architecture-building-systems/FCL-Exhibition-2023-Arduino/README.md

# FCL-Exhibition-2023
Arduino Installation 

Files and codes for the
- Arduino Sundomes

|  | 
|:--:| 
| *ETH main bulding Zurich 12 October 2023* |
