architecture-building-systems/FCL-Exhibition-2023-Arduino/09_Documentation/Images/2 axis prototype disect.pdf

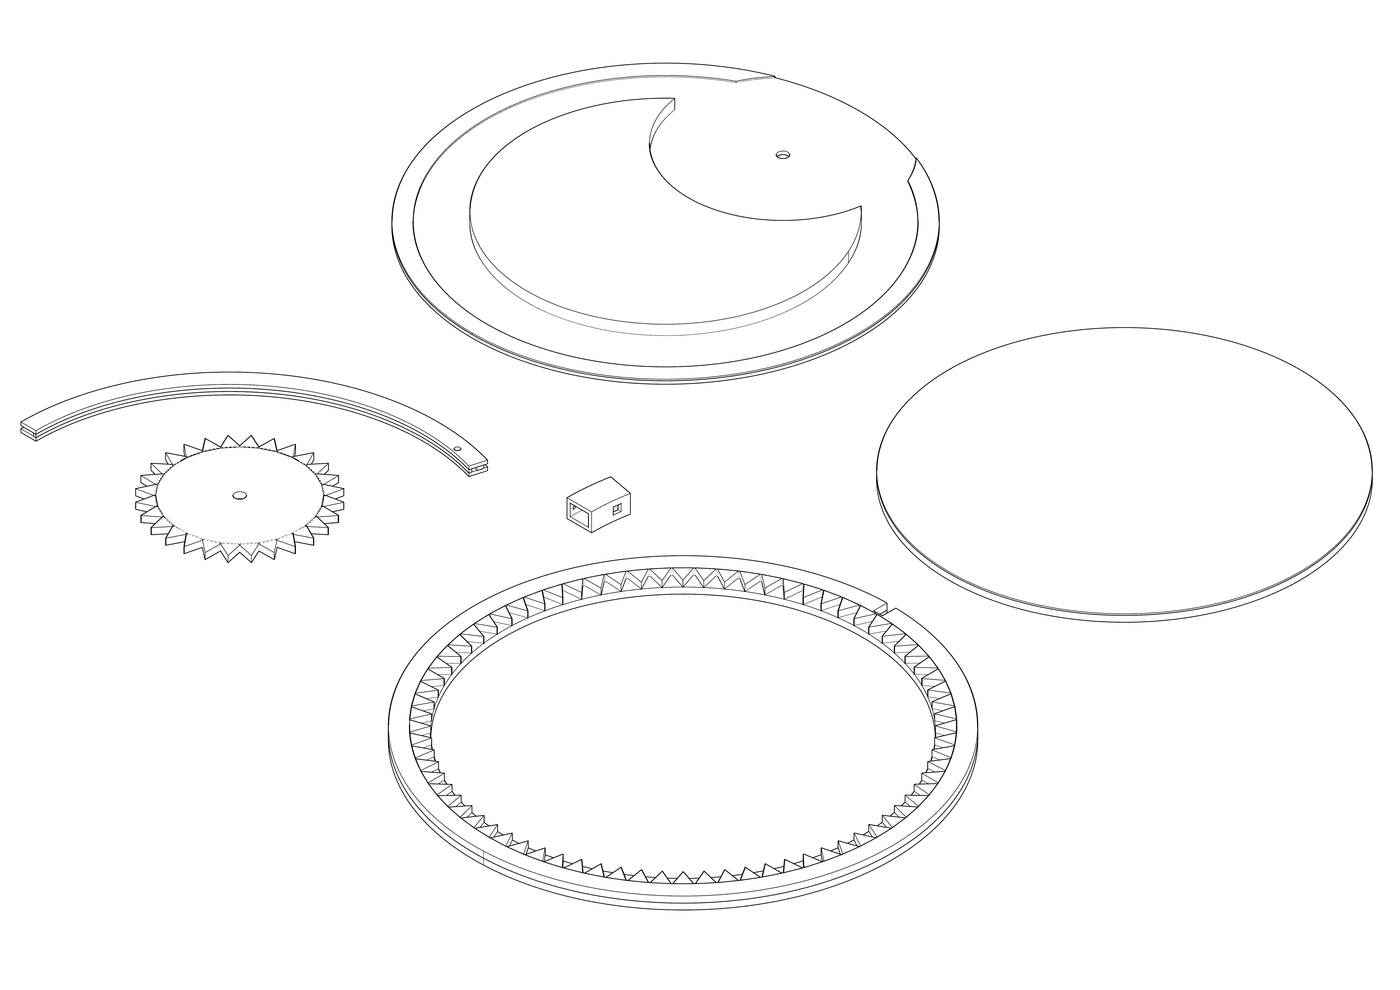
[picture p62: page 1]
