architecture-building-systems/FCL-Exhibition-2023-Arduino/09_Documentation/Images/2 axis prototype total.pdf

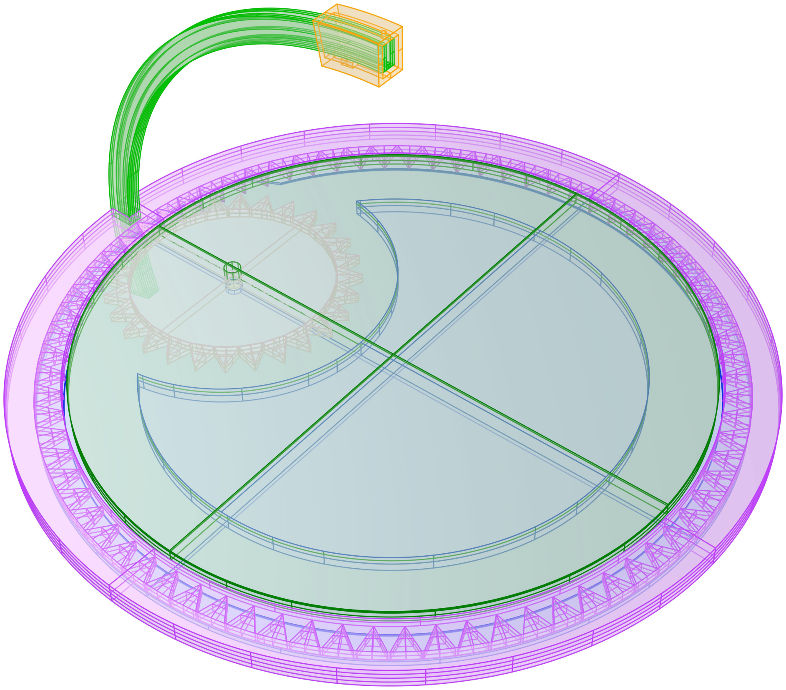
[picture p63: page 1]
