architecture-building-systems/FCL-Exhibition-2023-Arduino/09_Documentation/Images/modelsg.pdf

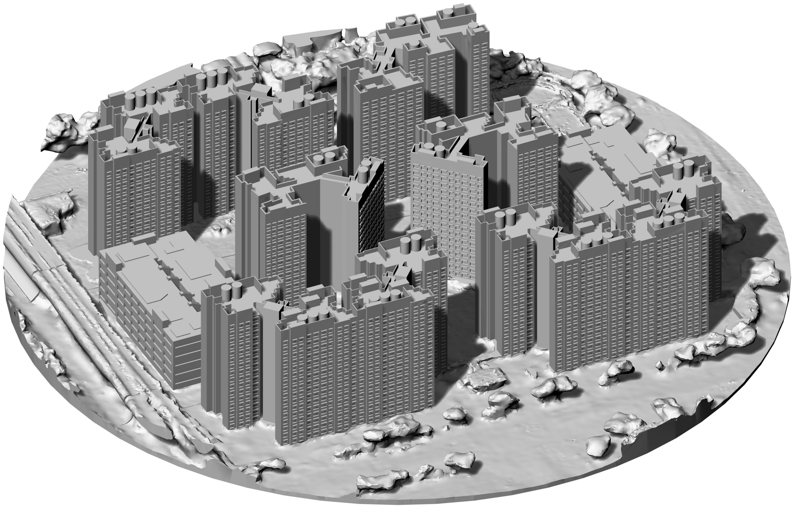
[picture p64: page 1]
