architecture-building-systems/FCL-Exhibition-2023-Arduino/09_Documentation/Images/modelzh.pdf

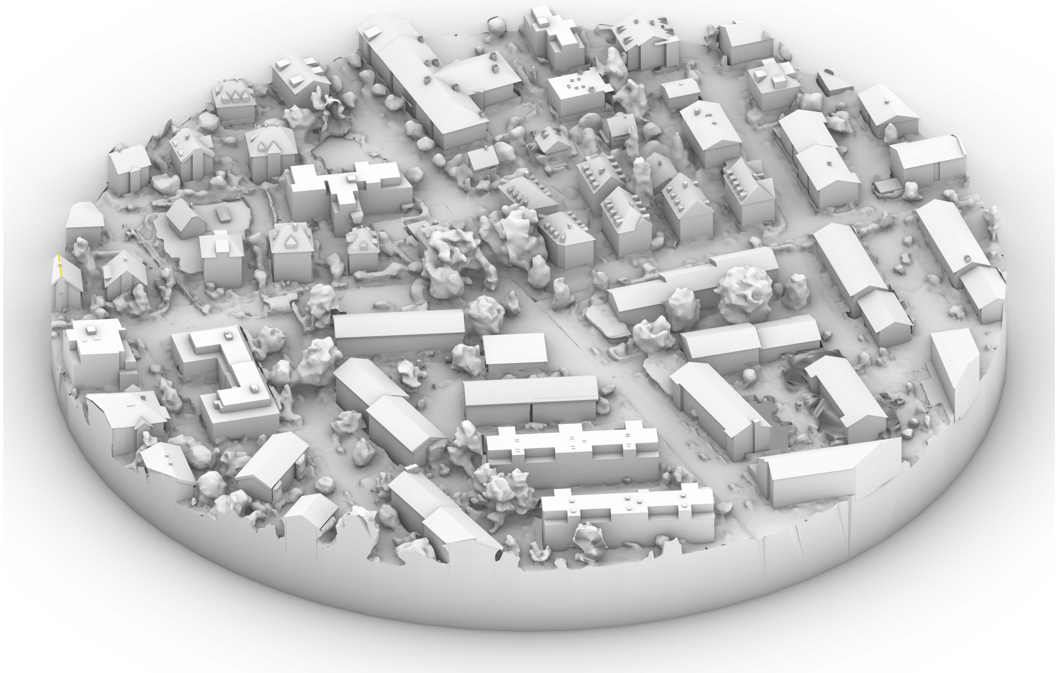
[picture p65: page 1]
