architecture-building-systems/FCL-Exhibition-2023-Arduino/09_Documentation/Images/ring prototype_v1 - disect.pdf

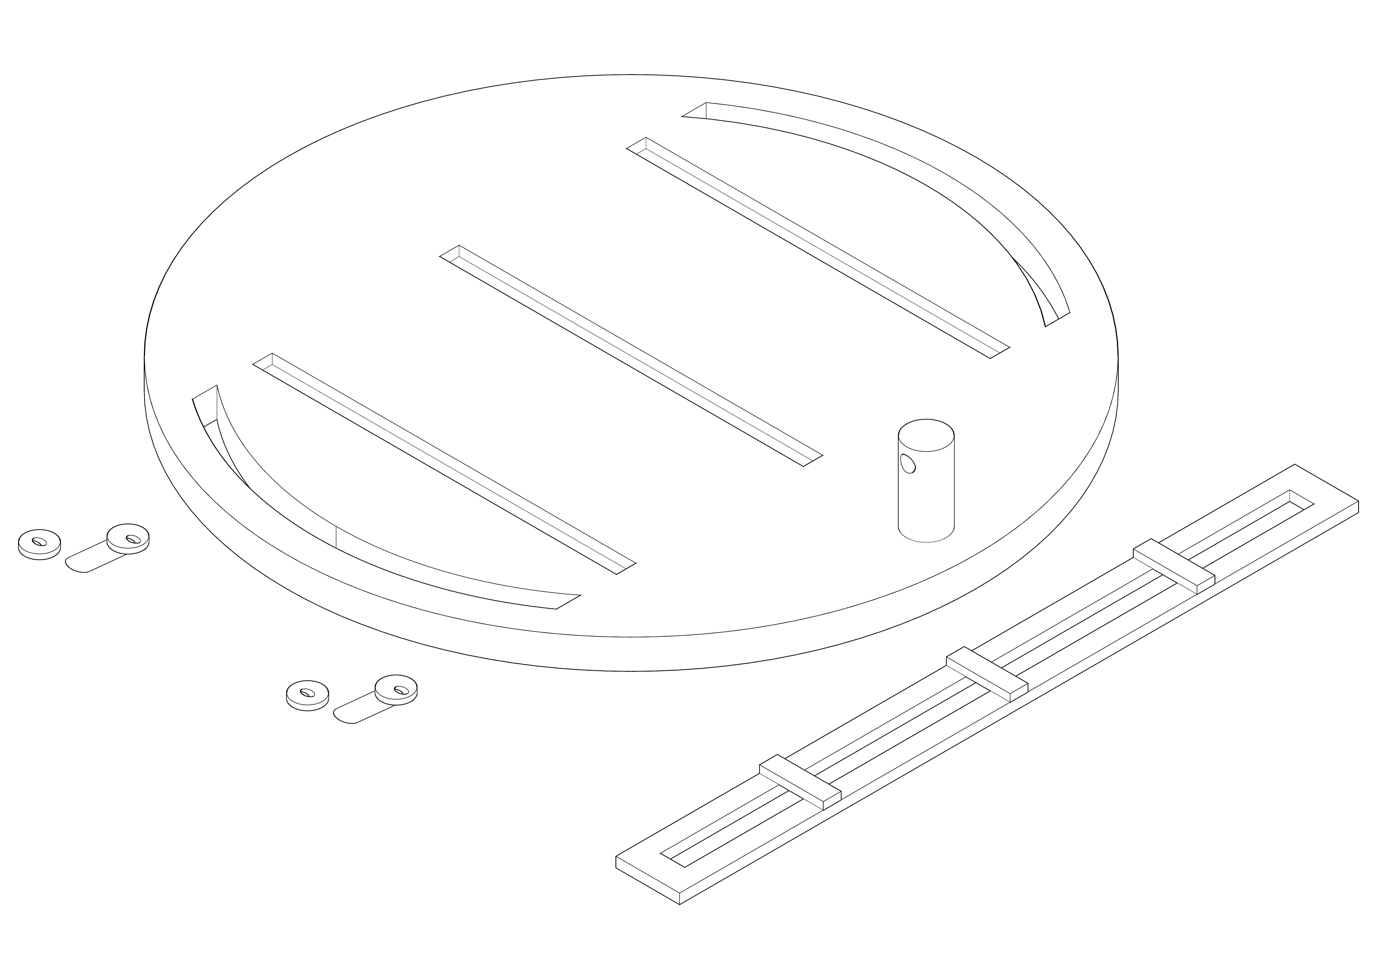
[picture p66: page 1]
