architecture-building-systems/FCL-Exhibition-2023-Arduino/09_Documentation/Images/ring prototype_v1 - total.pdf

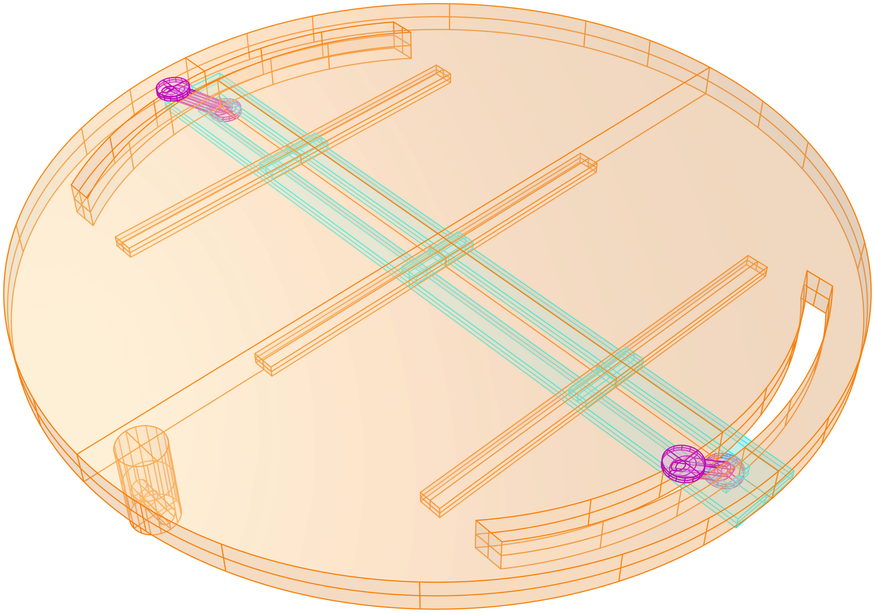
[picture p67: page 1]
