architecture-building-systems/FCL-Exhibition-2023-Arduino/09_Documentation/Images/ring prototype_v2 disect.pdf

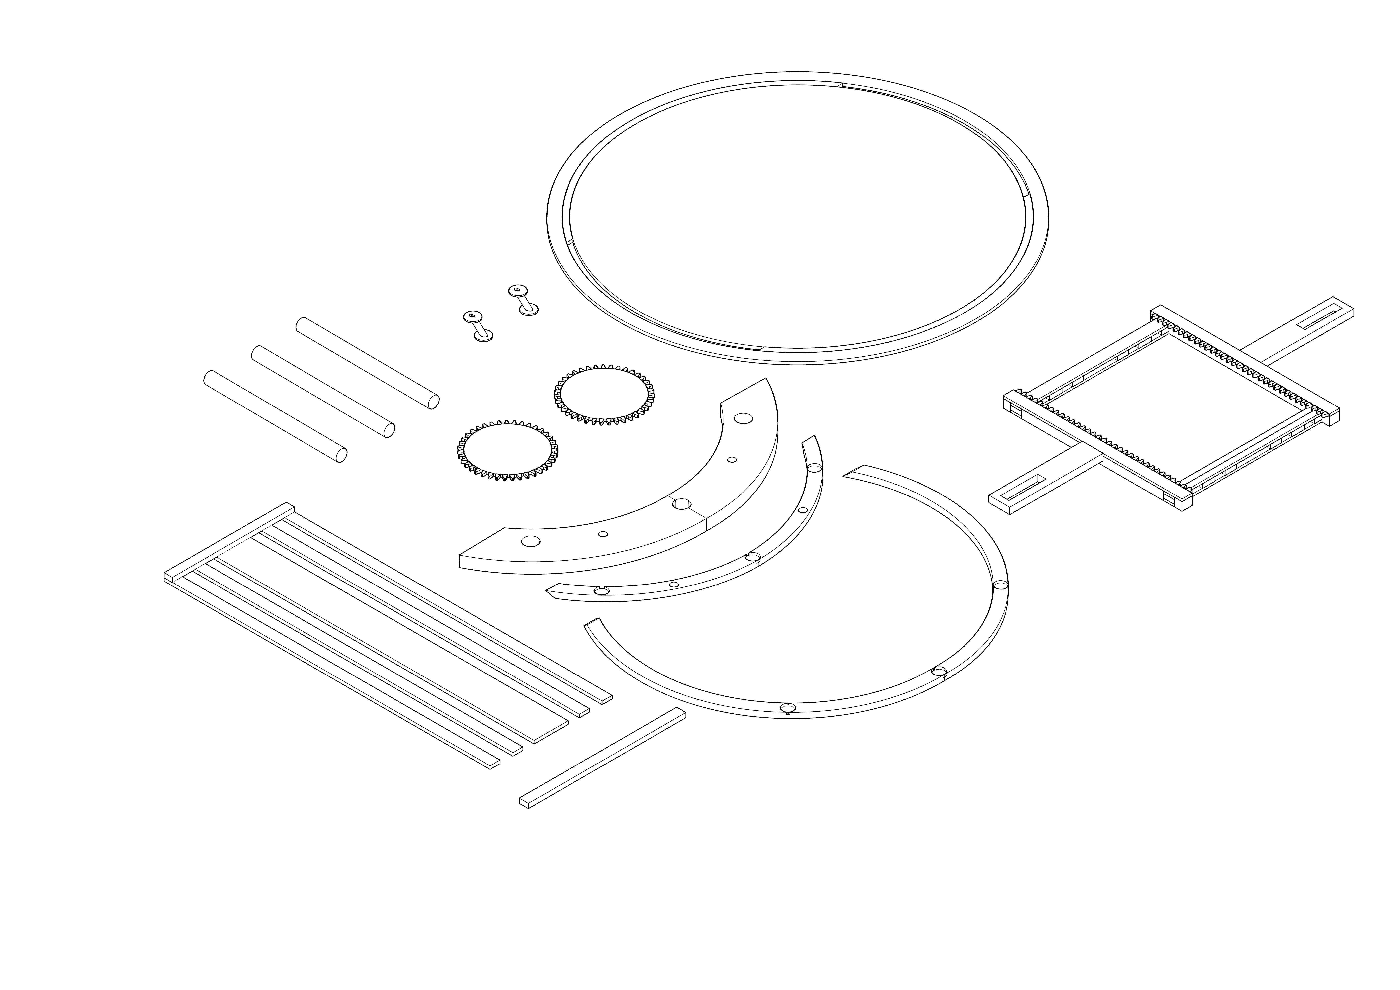
[picture p68: page 1]
