architecture-building-systems/FCL-Exhibition-2023-Arduino/09_Documentation/Images/ring prototype_v2 total.pdf

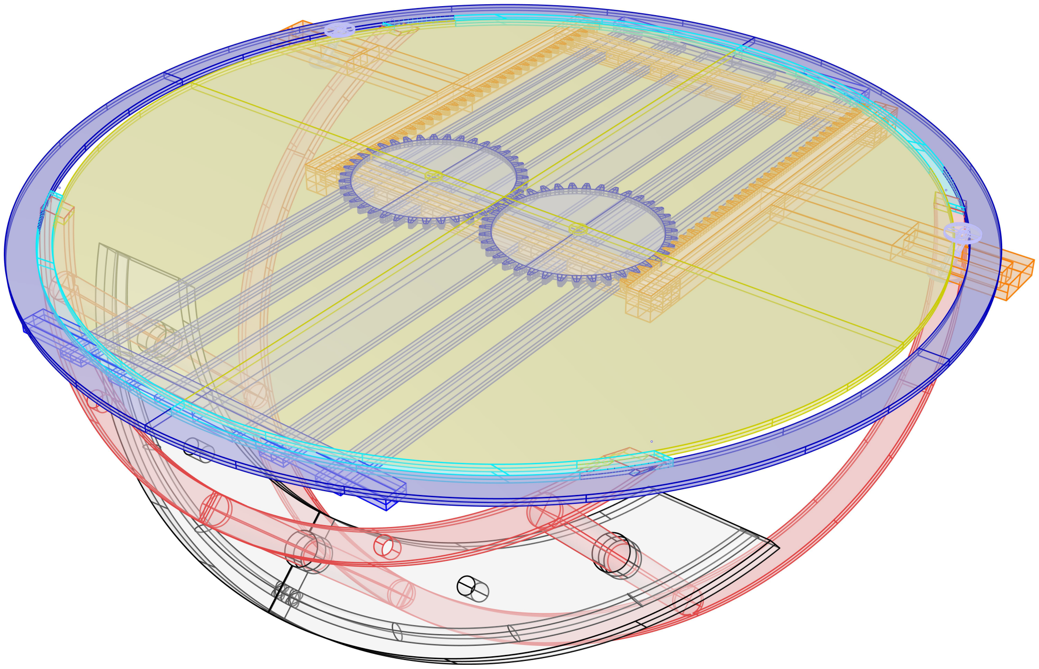
[picture p69: page 1]
