architecture-building-systems/FCL-Exhibition-2023-Arduino/09_Documentation/Images/7.jpg

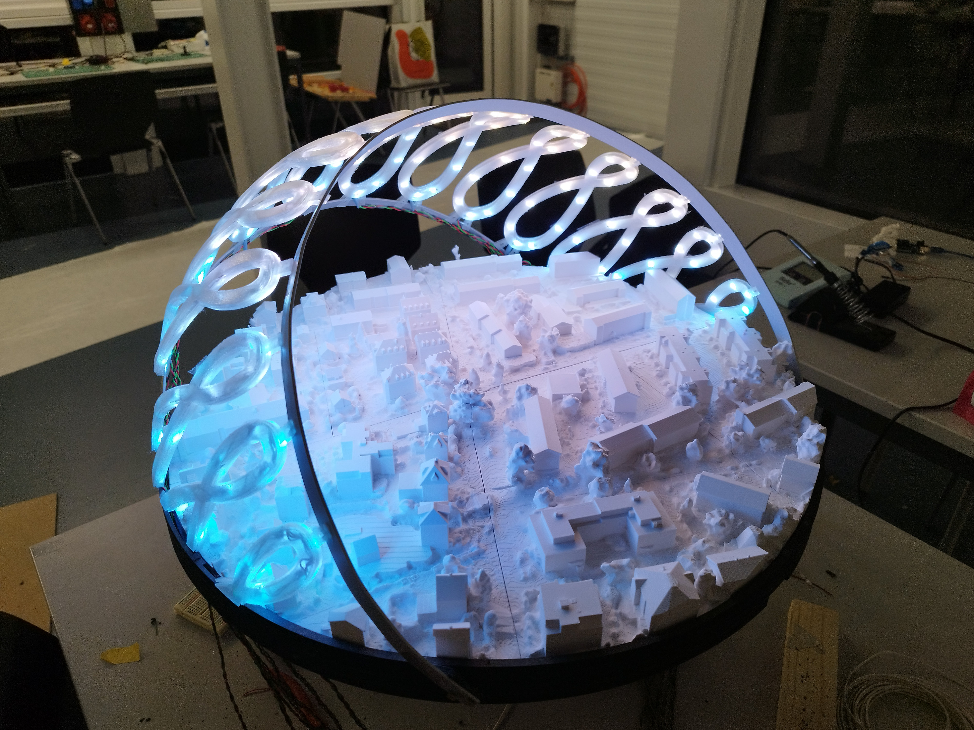
09_Documentation/Images/7.jpg
