architecture-building-systems/FCL-Exhibition-2023-Arduino/09_Documentation/Images/11.jpg

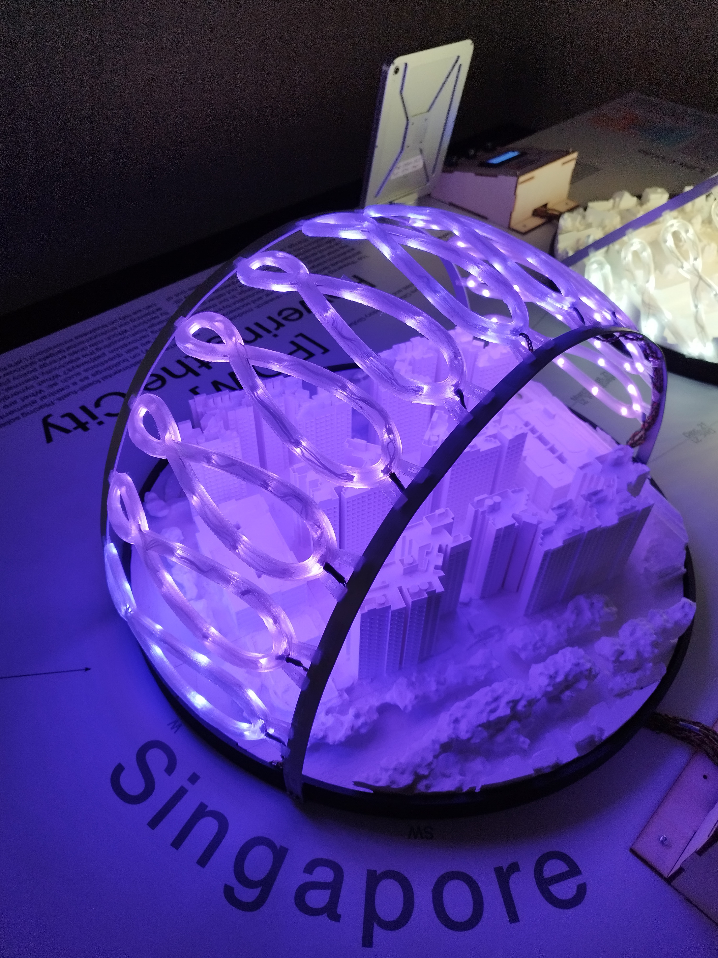
09_Documentation/Images/11.jpg
