architecture-building-systems/FCL-Exhibition-2023-Arduino/09_Documentation/Images/closedv2_1.jpg

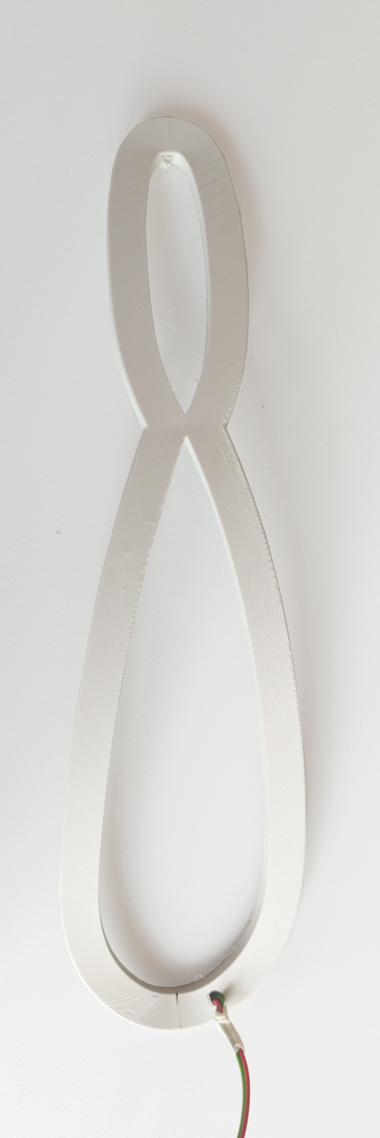
09_Documentation/Images/closedv2_1.jpg
