architecture-building-systems/FCL-Exhibition-2023-Arduino/09_Documentation/Images/scheme led_1.jpg

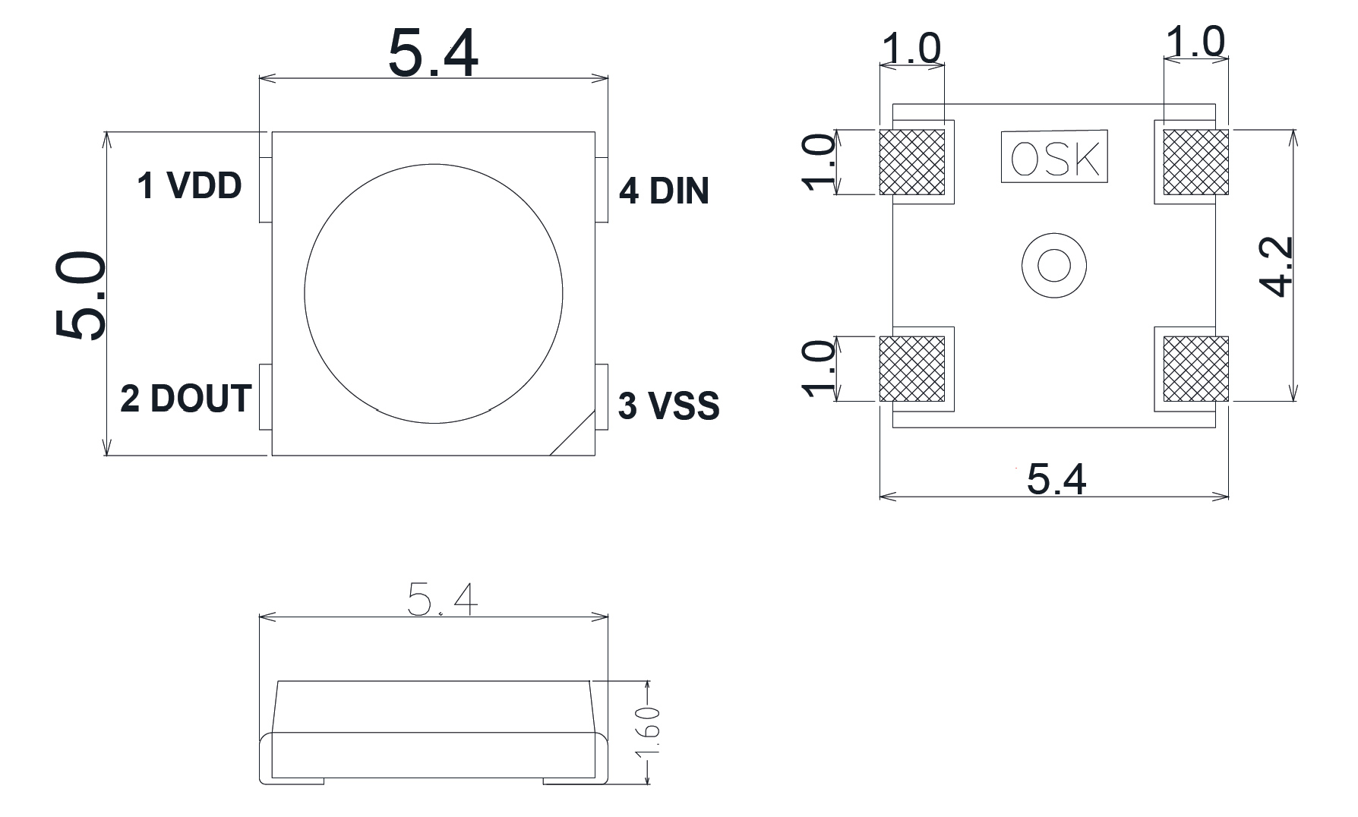
09_Documentation/Images/scheme led_1.jpg
