architecture-building-systems/FCL-Exhibition-2023-Arduino/07_3D-Printing_Model_Altstetten/02_stl/Q4.stl

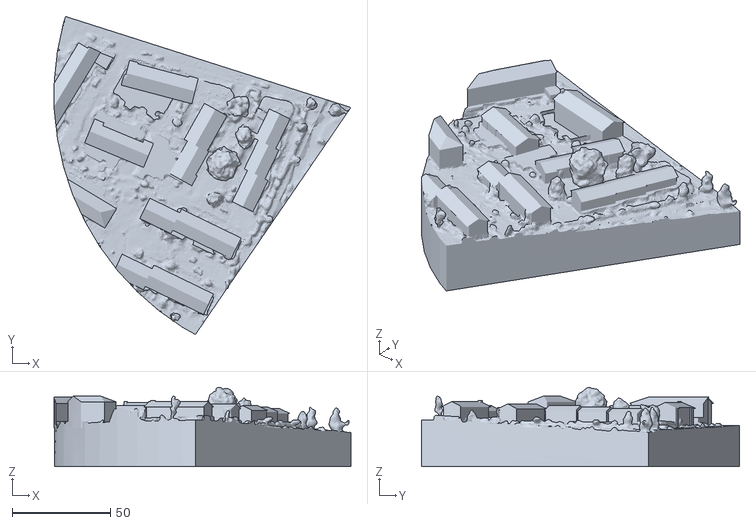
[picture p78: CAD file, 2023-10-27]
07_3D-Printing_Model_Altstetten/02_stl/Q4.stl
151.3 x 162.2 x 40.4
