architecture-building-systems/FCL-Exhibition-2023-Arduino/07_3D-Printing_Model_Altstetten/03_3mf/Q4.3mf

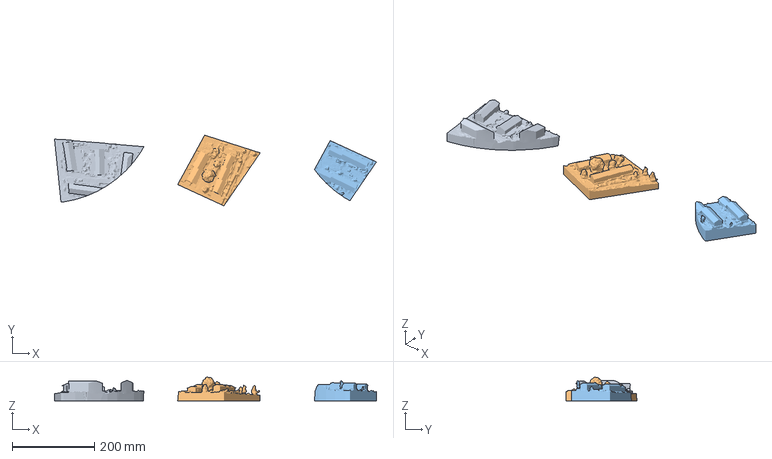
[picture p79: CAD file, 2023-10-27]
07_3D-Printing_Model_Altstetten/03_3mf/Q4.3mf
784.6 x 172.3 x 58.0 mm
Q4.stl x 3
