architecture-building-systems/FCL-Exhibition-2023-Arduino/10_Mechanical_Prototypes/01_two-axis mechanic/02_stl/zahnrad.stl

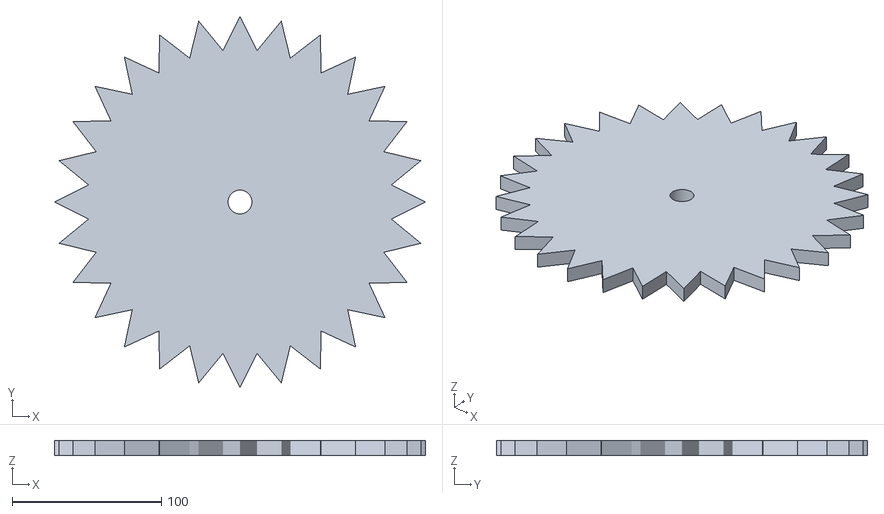
[picture p80: CAD file, 2023-10-27]
10_Mechanical_Prototypes/01_two-axis mechanic/02_stl/zahnrad.stl
248.4 x 248.4 x 10.0
