architecture-building-systems/FCL-Exhibition-2023-Arduino/10_Mechanical_Prototypes/01_two-axis mechanic/03_3mf/tablelower.3mf

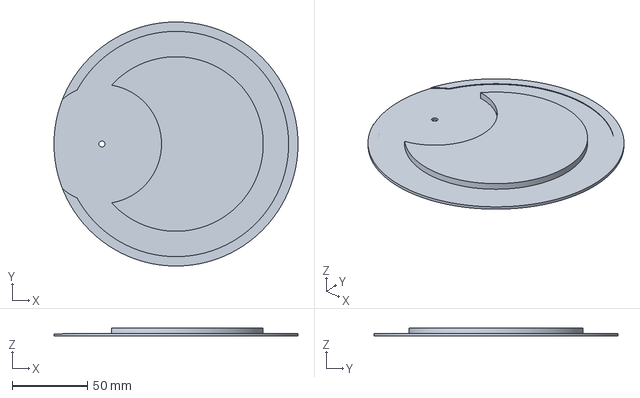
[picture p81: CAD file, 2023-10-27]
10_Mechanical_Prototypes/01_two-axis mechanic/03_3mf/tablelower.3mf
162.5 x 162.5 x 5.38 mm
