architecture-building-systems/FCL-Exhibition-2023-Arduino/10_Mechanical_Prototypes/02_ring mechanic/02_stl/01_v1/tube.stl

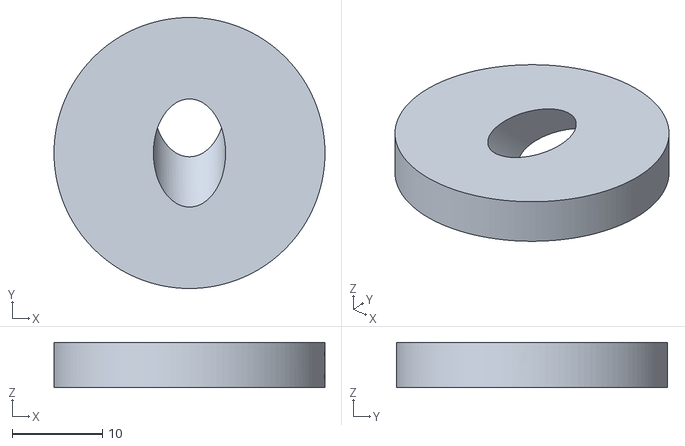
[picture p82: CAD file, 2023-10-27]
10_Mechanical_Prototypes/02_ring mechanic/02_stl/01_v1/tube.stl
30.0 x 30.0 x 5.00
