architecture-building-systems/FCL-Exhibition-2023-Arduino/10_Mechanical_Prototypes/02_ring mechanic/02_stl/02_v2/under.stl

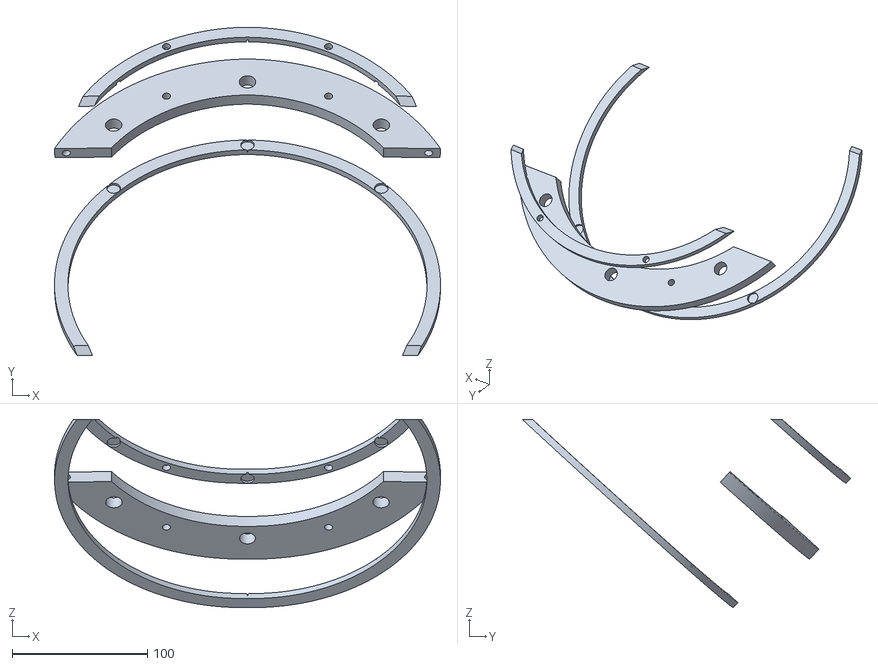
[picture p83: CAD file, 2023-10-27]
10_Mechanical_Prototypes/02_ring mechanic/02_stl/02_v2/under.stl
285.4 x 242.9 x 139.2
