architecture-building-systems/FCL-Exhibition-2023-Arduino/10_Mechanical_Prototypes/02_ring mechanic/03_3mf/01_v1/bar.3mf

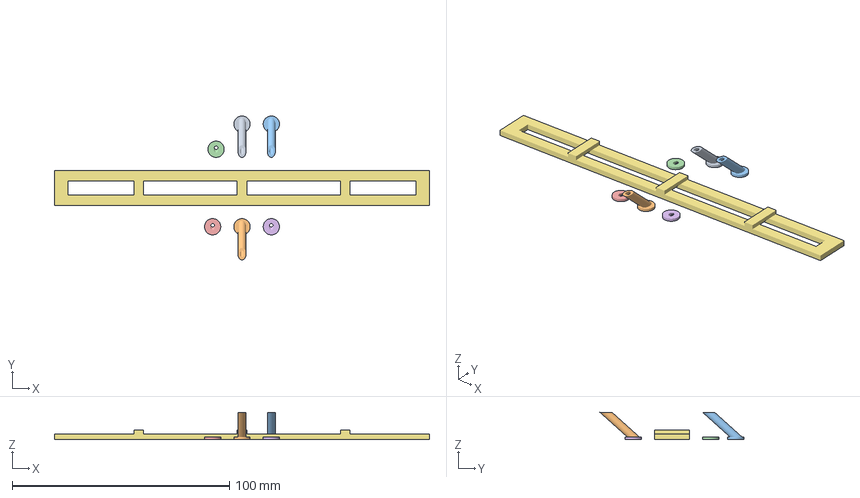
[picture p84: CAD file, 2023-10-27]
10_Mechanical_Prototypes/02_ring mechanic/03_3mf/01_v1/bar.3mf
172.5 x 66.3 x 12.5 mm
tube.stl x 3
tube2.stl x 3
bar.stl
