architecture-building-systems/FCL-Exhibition-2023-Arduino/10_Mechanical_Prototypes/02_ring mechanic/03_3mf/02_v2/plate.3mf

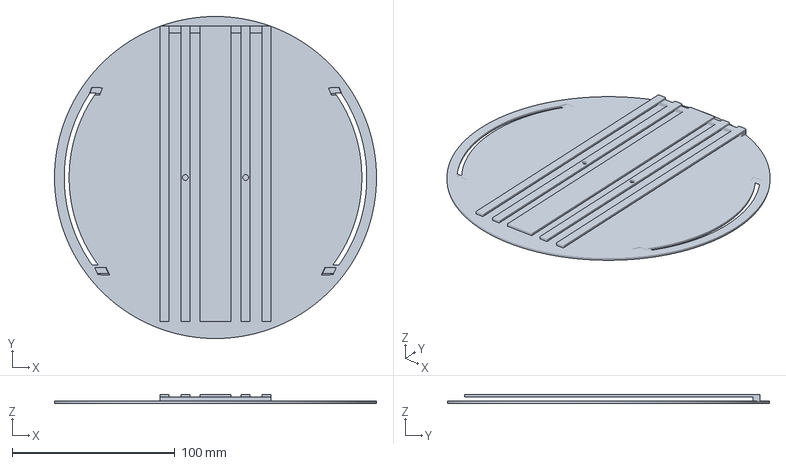
[picture p85: CAD file, 2023-10-27]
10_Mechanical_Prototypes/02_ring mechanic/03_3mf/02_v2/plate.3mf
198.0 x 198.0 x 5.52 mm
