architecture-building-systems/FCL-Exhibition-2023-Arduino/07_3D-Printing_Model_Altstetten/02_stl/Q2.stl

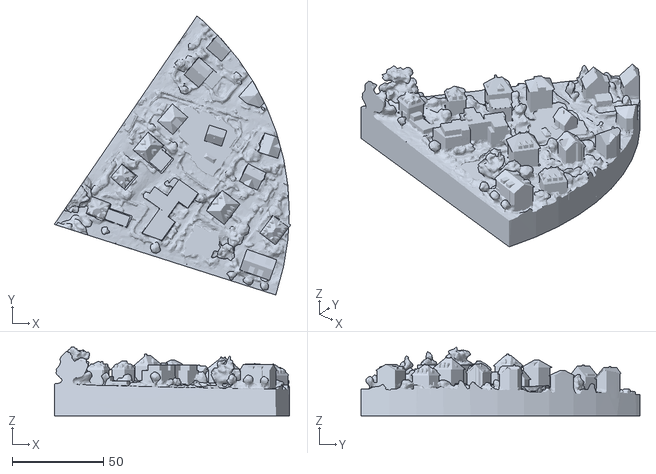
[picture p86: CAD file, 2023-10-27]
07_3D-Printing_Model_Altstetten/02_stl/Q2.stl
129.3 x 152.6 x 37.7
