architecture-building-systems/FCL-Exhibition-2023-Arduino/07_3D-Printing_Model_Altstetten/03_3mf/Q1.3mf

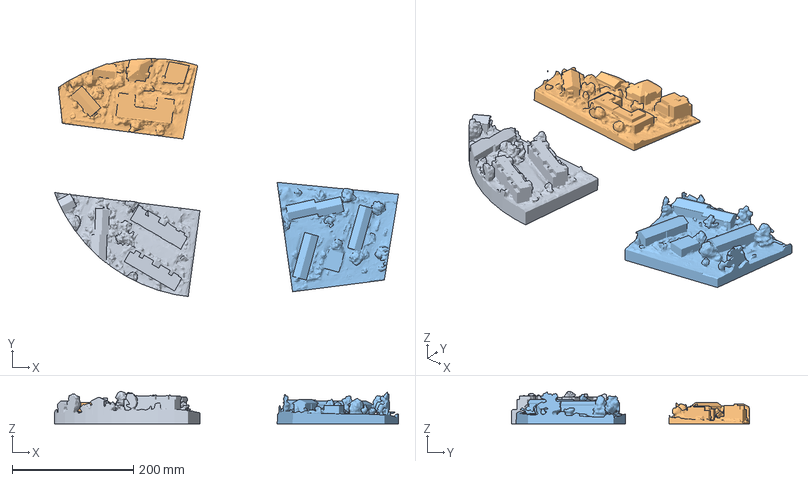
[picture p87: CAD file, 2023-10-27]
07_3D-Printing_Model_Altstetten/03_3mf/Q1.3mf
567.1 x 392.5 x 53.6 mm
Q1.stl x 3
