architecture-building-systems/FCL-Exhibition-2023-Arduino/10_Mechanical_Prototypes/01_two-axis mechanic/02_stl/slider.stl

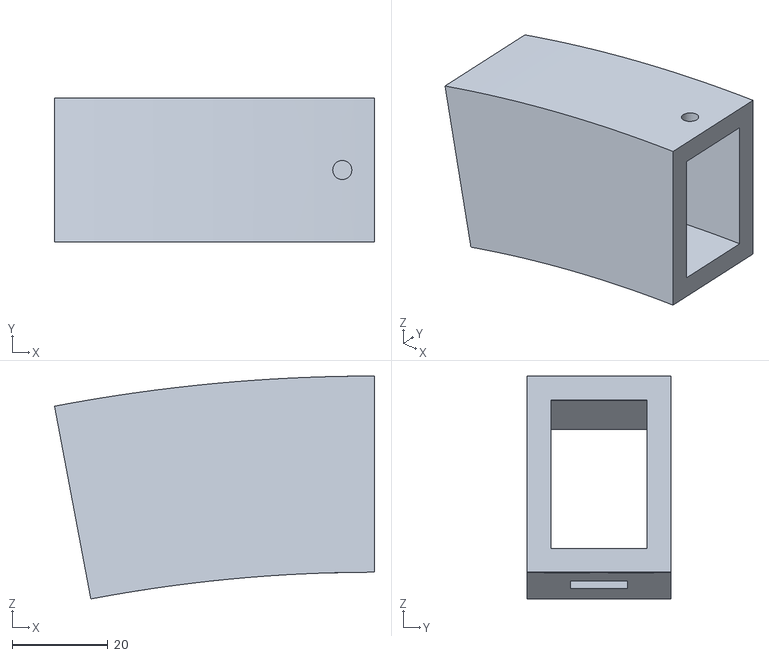
[picture p88: CAD file, 2023-10-27]
10_Mechanical_Prototypes/01_two-axis mechanic/02_stl/slider.stl
66.9 x 30.0 x 46.6
