architecture-building-systems/FCL-Exhibition-2023-Arduino/10_Mechanical_Prototypes/01_two-axis mechanic/03_3mf/tablelupper.3mf

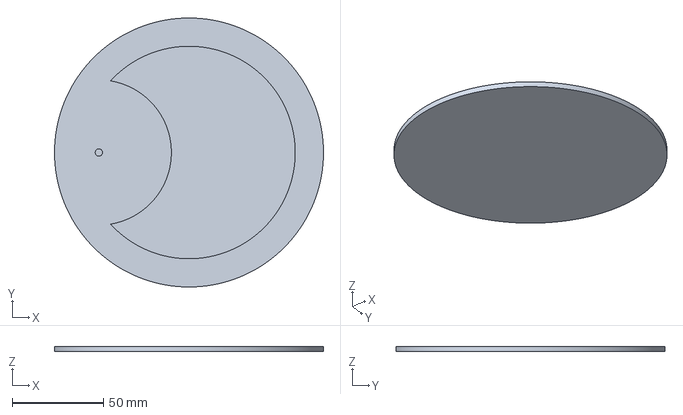
[picture p89: CAD file, 2023-10-27]
10_Mechanical_Prototypes/01_two-axis mechanic/03_3mf/tablelupper.3mf
147.2 x 147.2 x 3.00 mm
