architecture-building-systems/FCL-Exhibition-2023-Arduino/10_Mechanical_Prototypes/02_ring mechanic/02_stl/01_v1/plate.stl

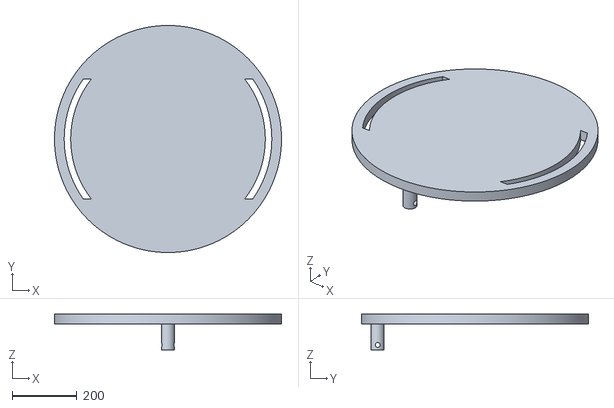
[picture p90: CAD file, 2023-10-27]
10_Mechanical_Prototypes/02_ring mechanic/02_stl/01_v1/plate.stl
700.0 x 700.0 x 110.0
