architecture-building-systems/FCL-Exhibition-2023-Arduino/10_Mechanical_Prototypes/02_ring mechanic/02_stl/02_v2/stab.stl

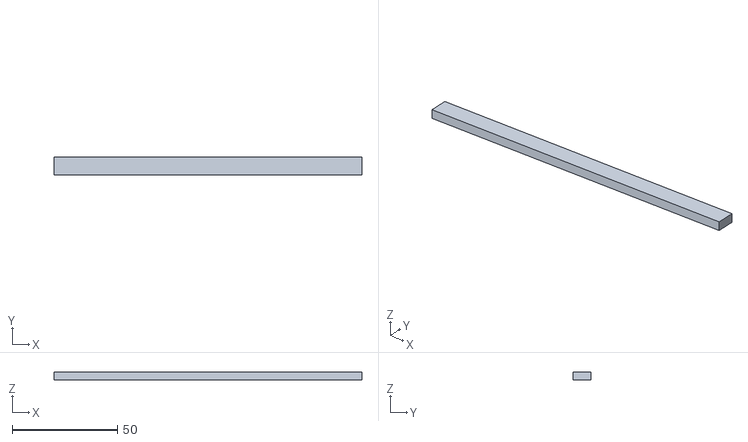
[picture p91: CAD file, 2023-10-27]
10_Mechanical_Prototypes/02_ring mechanic/02_stl/02_v2/stab.stl
146.3 x 8.37 x 4.00
