architecture-building-systems/FCL-Exhibition-2023-Arduino/10_Mechanical_Prototypes/02_ring mechanic/03_3mf/01_v1/plate.3mf

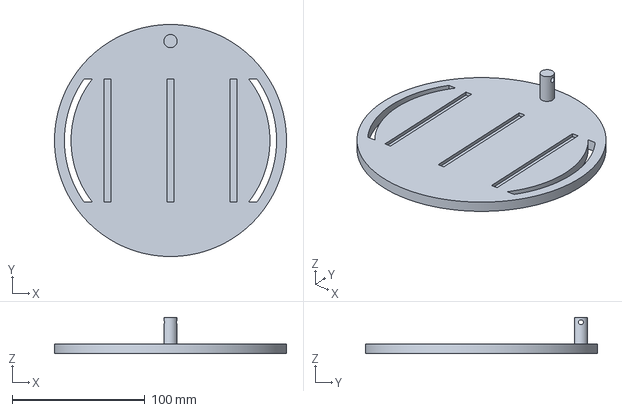
[picture p92: CAD file, 2023-10-27]
10_Mechanical_Prototypes/02_ring mechanic/03_3mf/01_v1/plate.3mf
175.0 x 175.0 x 27.5 mm
