architecture-building-systems/FCL-Exhibition-2023-Arduino/10_Mechanical_Prototypes/02_ring mechanic/03_3mf/02_v2/gear.3mf

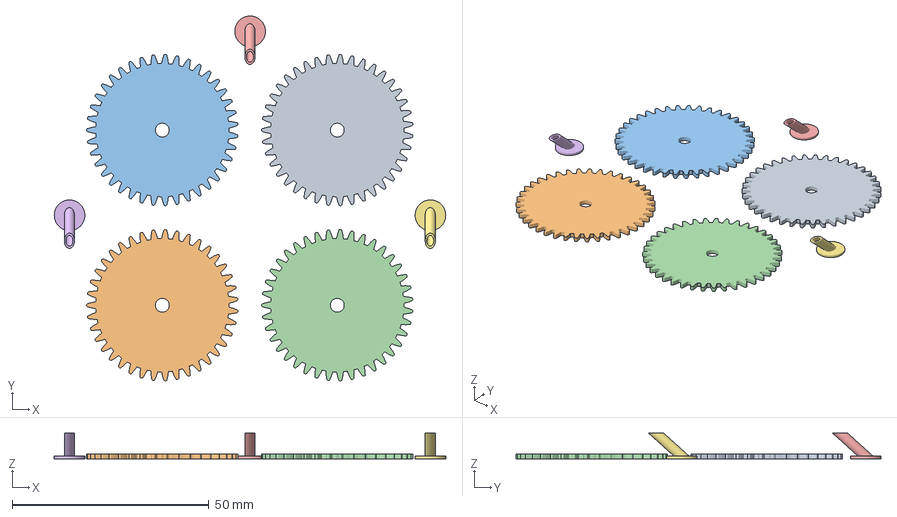
[picture p93: CAD file, 2023-10-27]
10_Mechanical_Prototypes/02_ring mechanic/03_3mf/02_v2/gear.3mf
99.6 x 92.8 x 6.50 mm
zahnrad.stl
slider.stl
