architecture-building-systems/FCL-Exhibition-2023-Arduino/07_3D-Printing_Model_Altstetten/02_stl/Q3.stl

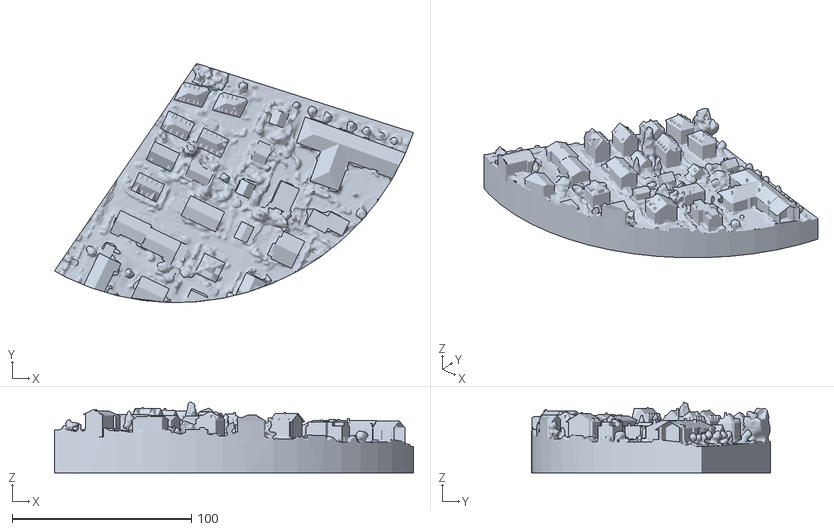
[picture p94: CAD file, 2023-10-27]
07_3D-Printing_Model_Altstetten/02_stl/Q3.stl
200.3 x 133.5 x 39.5
