architecture-building-systems/FCL-Exhibition-2023-Arduino/07_3D-Printing_Model_Altstetten/03_3mf/Q3.3mf

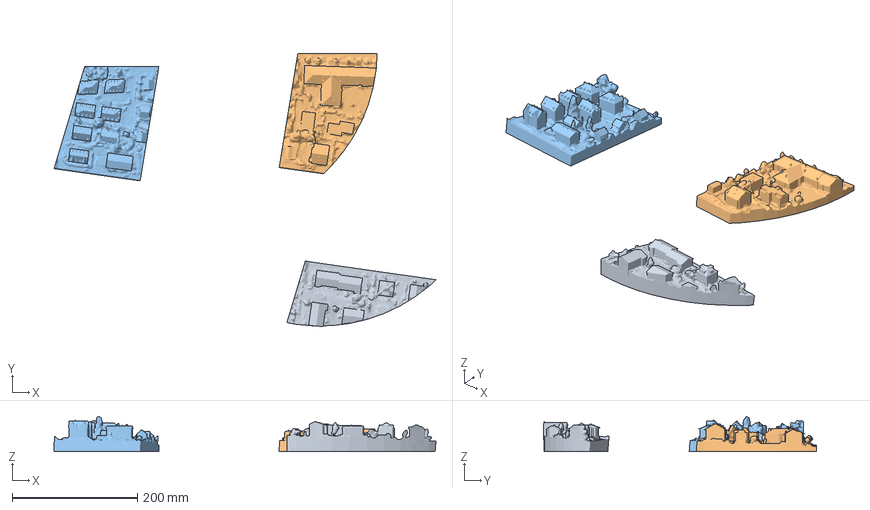
[picture p95: CAD file, 2023-10-27]
07_3D-Printing_Model_Altstetten/03_3mf/Q3.3mf
610.0 x 436.7 x 56.3 mm
Q3.stl x 3
