architecture-building-systems/FCL-Exhibition-2023-Arduino/10_Mechanical_Prototypes/01_two-axis mechanic/02_stl/bow.stl

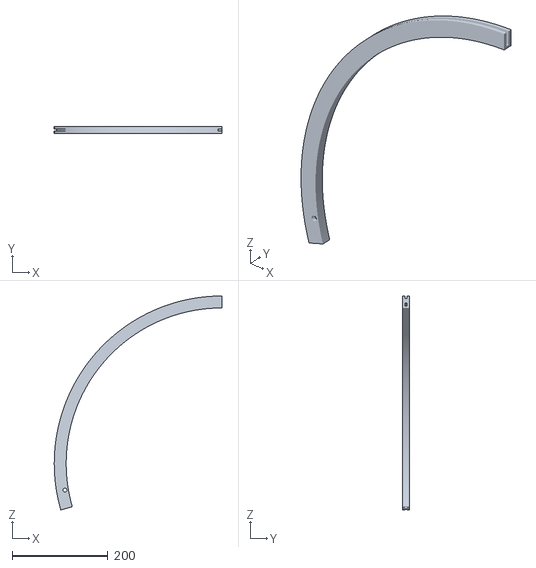
[picture p96: CAD file, 2023-10-27]
10_Mechanical_Prototypes/01_two-axis mechanic/02_stl/bow.stl
350.0 x 15.0 x 447.1
