architecture-building-systems/FCL-Exhibition-2023-Arduino/10_Mechanical_Prototypes/01_two-axis mechanic/03_3mf/bow.3mf

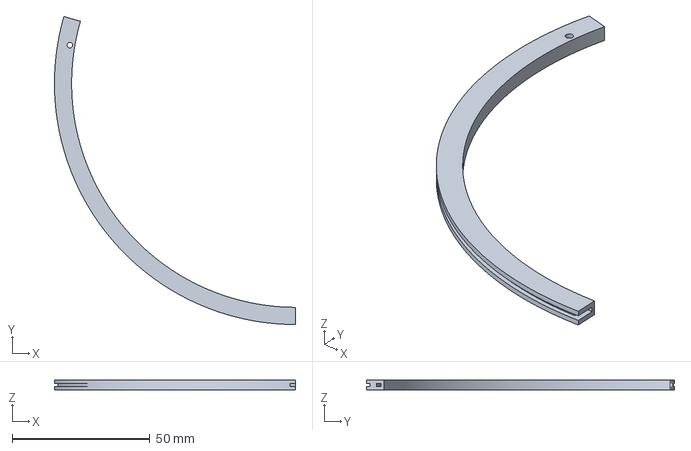
[picture p97: CAD file, 2023-10-27]
10_Mechanical_Prototypes/01_two-axis mechanic/03_3mf/bow.3mf
87.5 x 111.8 x 3.75 mm
