architecture-building-systems/FCL-Exhibition-2023-Arduino/10_Mechanical_Prototypes/02_ring mechanic/02_stl/01_v1/bar.stl

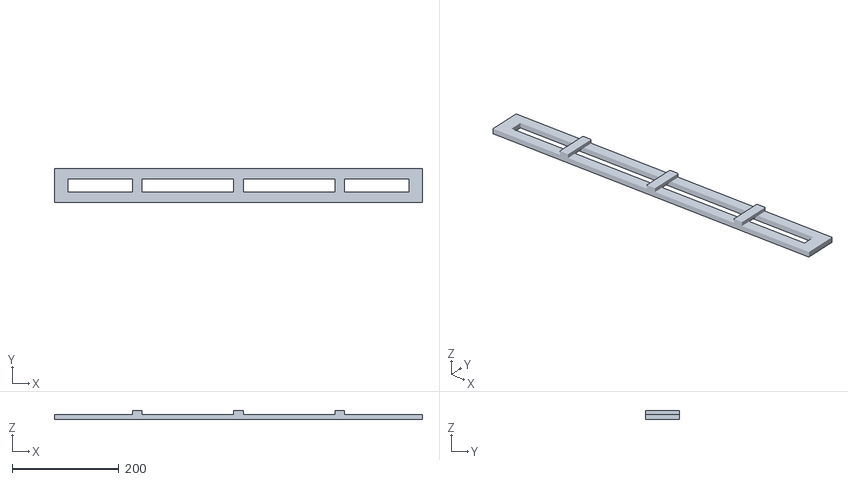
[picture p98: CAD file, 2023-10-27]
10_Mechanical_Prototypes/02_ring mechanic/02_stl/01_v1/bar.stl
690.1 x 64.6 x 17.5
