architecture-building-systems/FCL-Exhibition-2023-Arduino/10_Mechanical_Prototypes/02_ring mechanic/02_stl/02_v2/zyl.stl

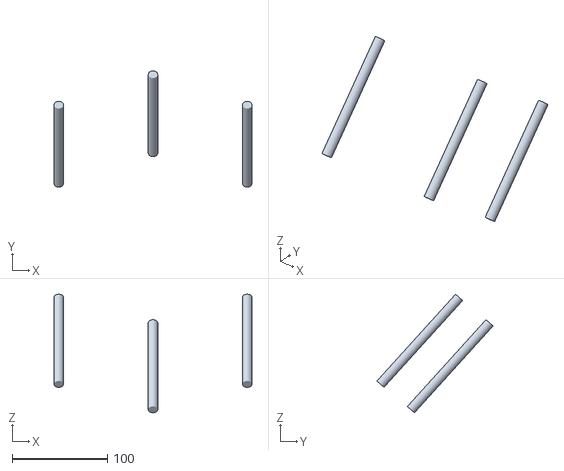
[picture p99: CAD file, 2023-10-27]
10_Mechanical_Prototypes/02_ring mechanic/02_stl/02_v2/zyl.stl
207.9 x 122.1 x 124.5
