architecture-building-systems/FCL-Exhibition-2023-Arduino/10_Mechanical_Prototypes/02_ring mechanic/03_3mf/02_v2/zyl.3mf

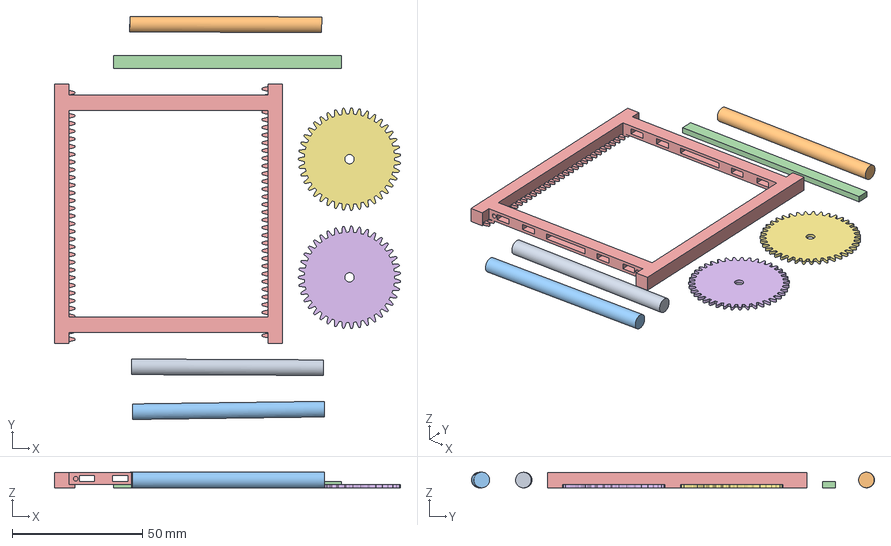
[picture p100: CAD file, 2023-10-27]
10_Mechanical_Prototypes/02_ring mechanic/03_3mf/02_v2/zyl.3mf
133.2 x 155.0 x 6.02 mm
zyl.stl_1
zyl.stl_2
zyl.stl_3
stab.stl
frame.stl
zahnrad.stl
