architecture-building-systems/FCL-Exhibition-2023-Arduino/07_3D-Printing_Model_Altstetten/02_stl/Q1.stl

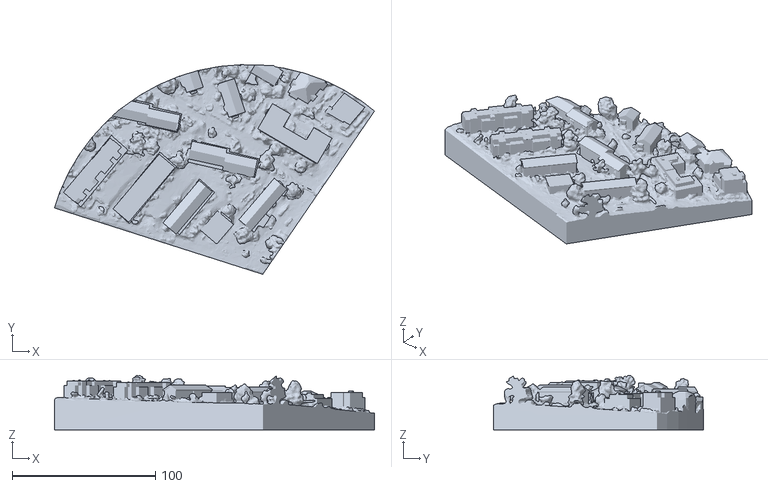
[picture p101: CAD file, 2023-10-27]
07_3D-Printing_Model_Altstetten/02_stl/Q1.stl
223.5 x 146.4 x 38.1
