architecture-building-systems/FCL-Exhibition-2023-Arduino/07_3D-Printing_Model_Altstetten/03_3mf/Q2.3mf

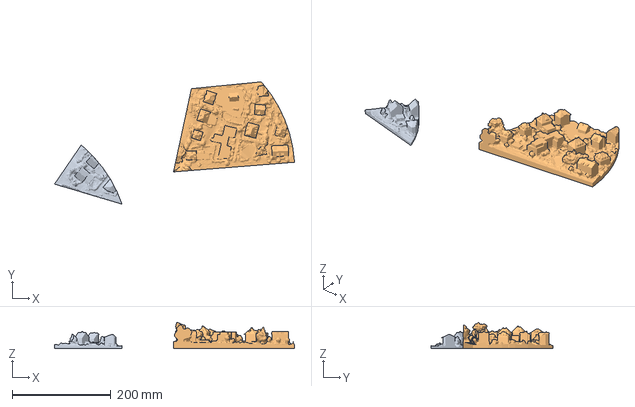
[picture p102: CAD file, 2023-10-27]
07_3D-Printing_Model_Altstetten/03_3mf/Q2.3mf
485.1 x 247.3 x 52.8 mm
Q2.stl x 2
