architecture-building-systems/FCL-Exhibition-2023-Arduino/10_Mechanical_Prototypes/01_two-axis mechanic/02_stl/table upper.stl

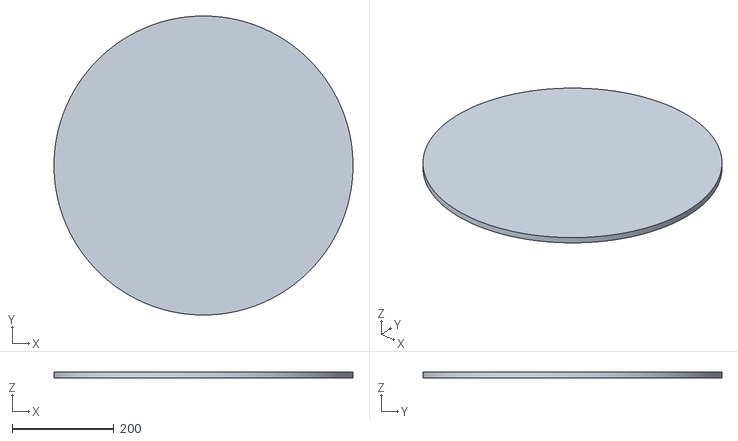
[picture p103: CAD file, 2023-10-27]
10_Mechanical_Prototypes/01_two-axis mechanic/02_stl/table upper.stl
588.6 x 588.6 x 12.0
