architecture-building-systems/FCL-Exhibition-2023-Arduino/10_Mechanical_Prototypes/01_two-axis mechanic/03_3mf/slider.3mf

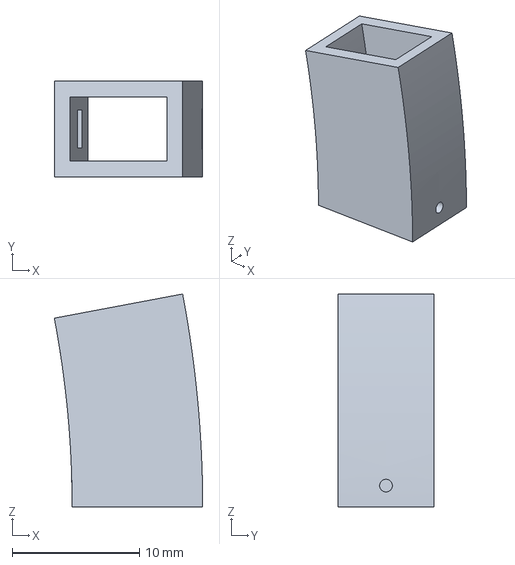
[picture p104: CAD file, 2023-10-27]
10_Mechanical_Prototypes/01_two-axis mechanic/03_3mf/slider.3mf
11.6 x 7.50 x 16.7 mm
