architecture-building-systems/FCL-Exhibition-2023-Arduino/10_Mechanical_Prototypes/02_ring mechanic/02_stl/02_v2/frame.stl

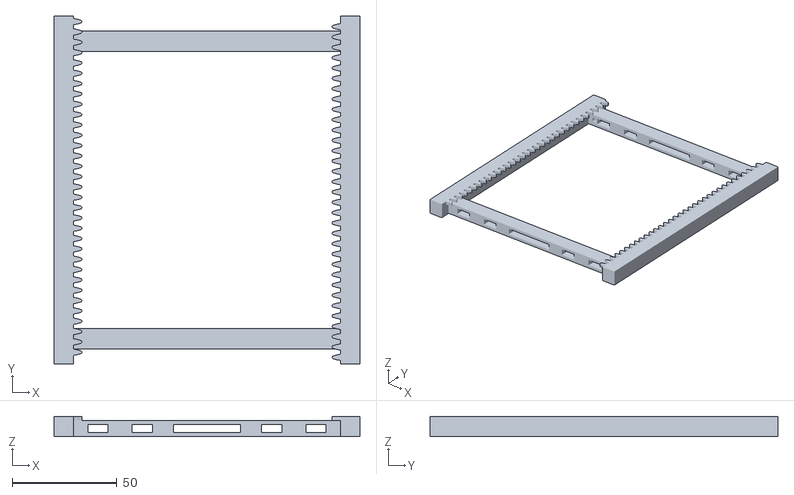
[picture p105: CAD file, 2023-10-27]
10_Mechanical_Prototypes/02_ring mechanic/02_stl/02_v2/frame.stl
146.3 x 166.3 x 9.80
