architecture-building-systems/FCL-Exhibition-2023-Arduino/10_Mechanical_Prototypes/02_ring mechanic/03_3mf/02_v2/under.3mf

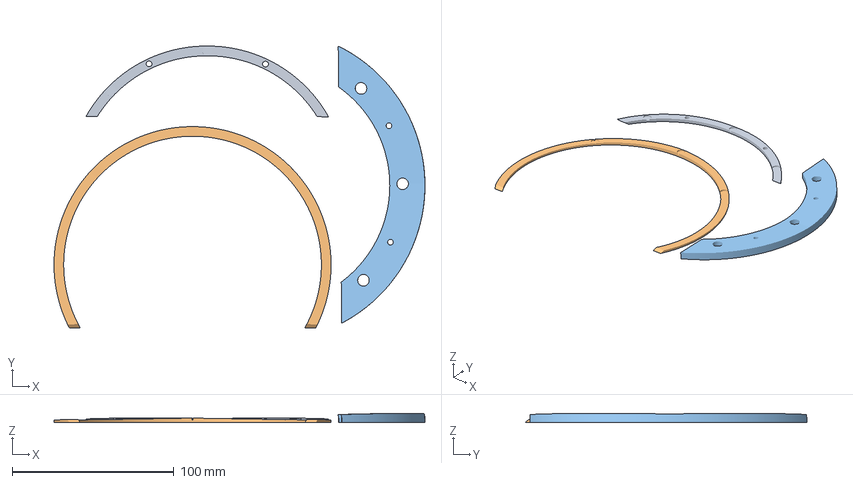
[picture p106: CAD file, 2023-10-27]
10_Mechanical_Prototypes/02_ring mechanic/03_3mf/02_v2/under.3mf
229.3 x 174.2 x 5.82 mm
under.stl_3
under.stl_1
under.stl_2
