architecture-building-systems/FCL-Exhibition-2023-Arduino/10_Mechanical_Prototypes/01_two-axis mechanic/02_stl/zahnkranz.stl

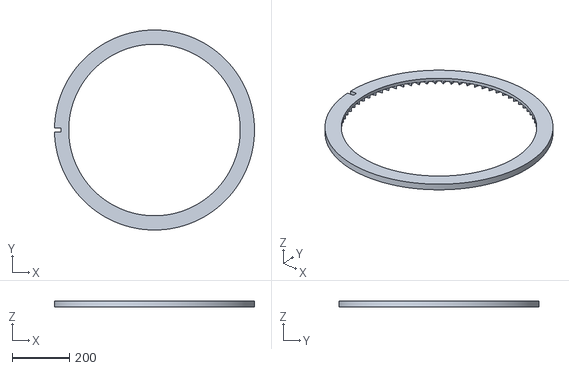
[picture p107: CAD file, 2023-10-27]
10_Mechanical_Prototypes/01_two-axis mechanic/02_stl/zahnkranz.stl
699.9 x 700.0 x 20.0
