architecture-building-systems/FCL-Exhibition-2023-Arduino/10_Mechanical_Prototypes/01_two-axis mechanic/03_3mf/zahnstuff.3mf

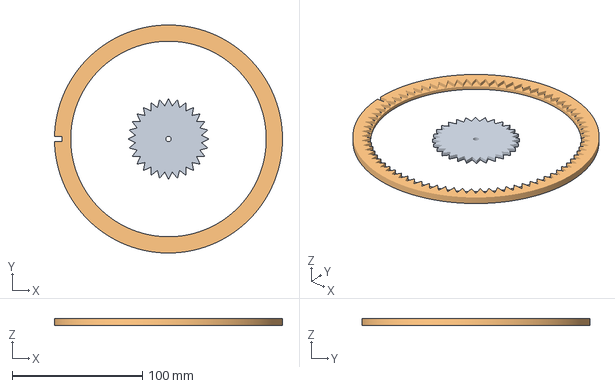
[picture p108: CAD file, 2023-10-27]
10_Mechanical_Prototypes/01_two-axis mechanic/03_3mf/zahnstuff.3mf
175.0 x 175.0 x 5.00 mm
zahnrad.stl
zahnkranz.stl
