architecture-building-systems/FCL-Exhibition-2023-Arduino/10_Mechanical_Prototypes/02_ring mechanic/02_stl/02_v2/table.stl

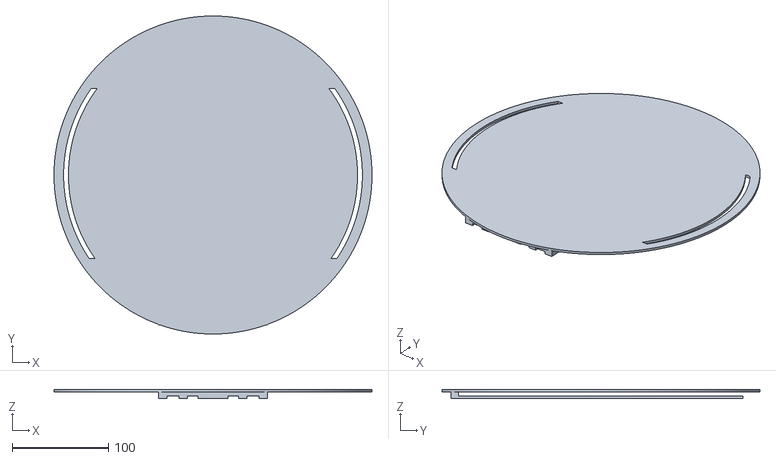
[picture p109: CAD file, 2023-10-27]
10_Mechanical_Prototypes/02_ring mechanic/02_stl/02_v2/table.stl
330.0 x 330.0 x 9.20
