architecture-building-systems/FCL-Exhibition-2023-Arduino/(list of files, cad)

Other CAD files:
05_Control Box/01_Rhino-file/Control Box.3dm
10_Mechanical_Prototypes/02_ring mechanic/01_Rhino file/ring_prototype_v1.3dm
