architecture-building-systems/FCL-Exhibition-2023-Arduino/09_Documentation/Images/plan software.pdf

Input | Loop | Output

# Data

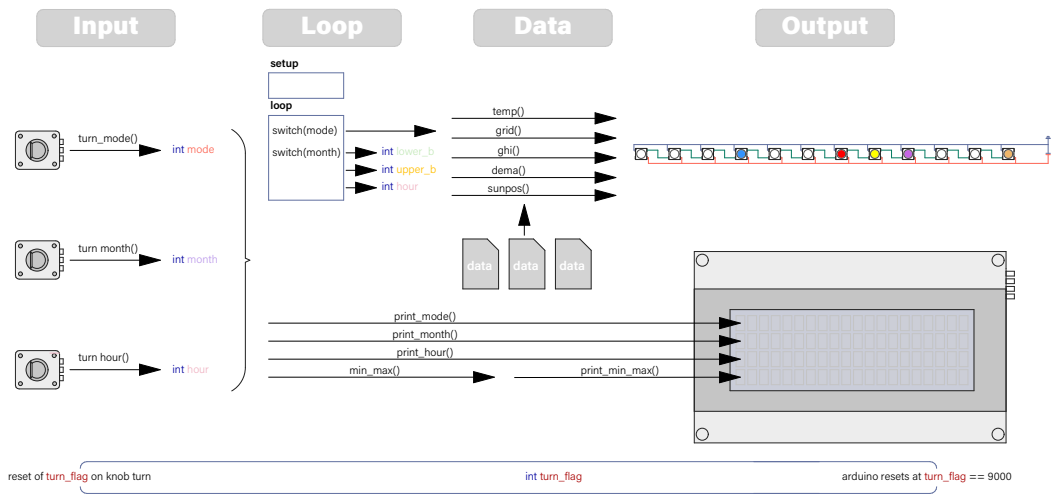
[picture p111: page 1]
turn_mode(); int mode; turn month(); int month; turn hour(); int hour; print_month(); print_mode(); print_hour(); min_max(); dema(); ghi(); grid(); temp(); sunpos(); switch(mode); loop; switch(month); int lower_b; int upper_b; data; setup; print_min_max(); reset of turn_flag on knob turn; int turn_flag; arduino resets at turn_flag == 9000
