architecture-building-systems/FCL-Exhibition-2023-Arduino/09_Documentation/Images/schaltplan SG.pdf

5V

# Months

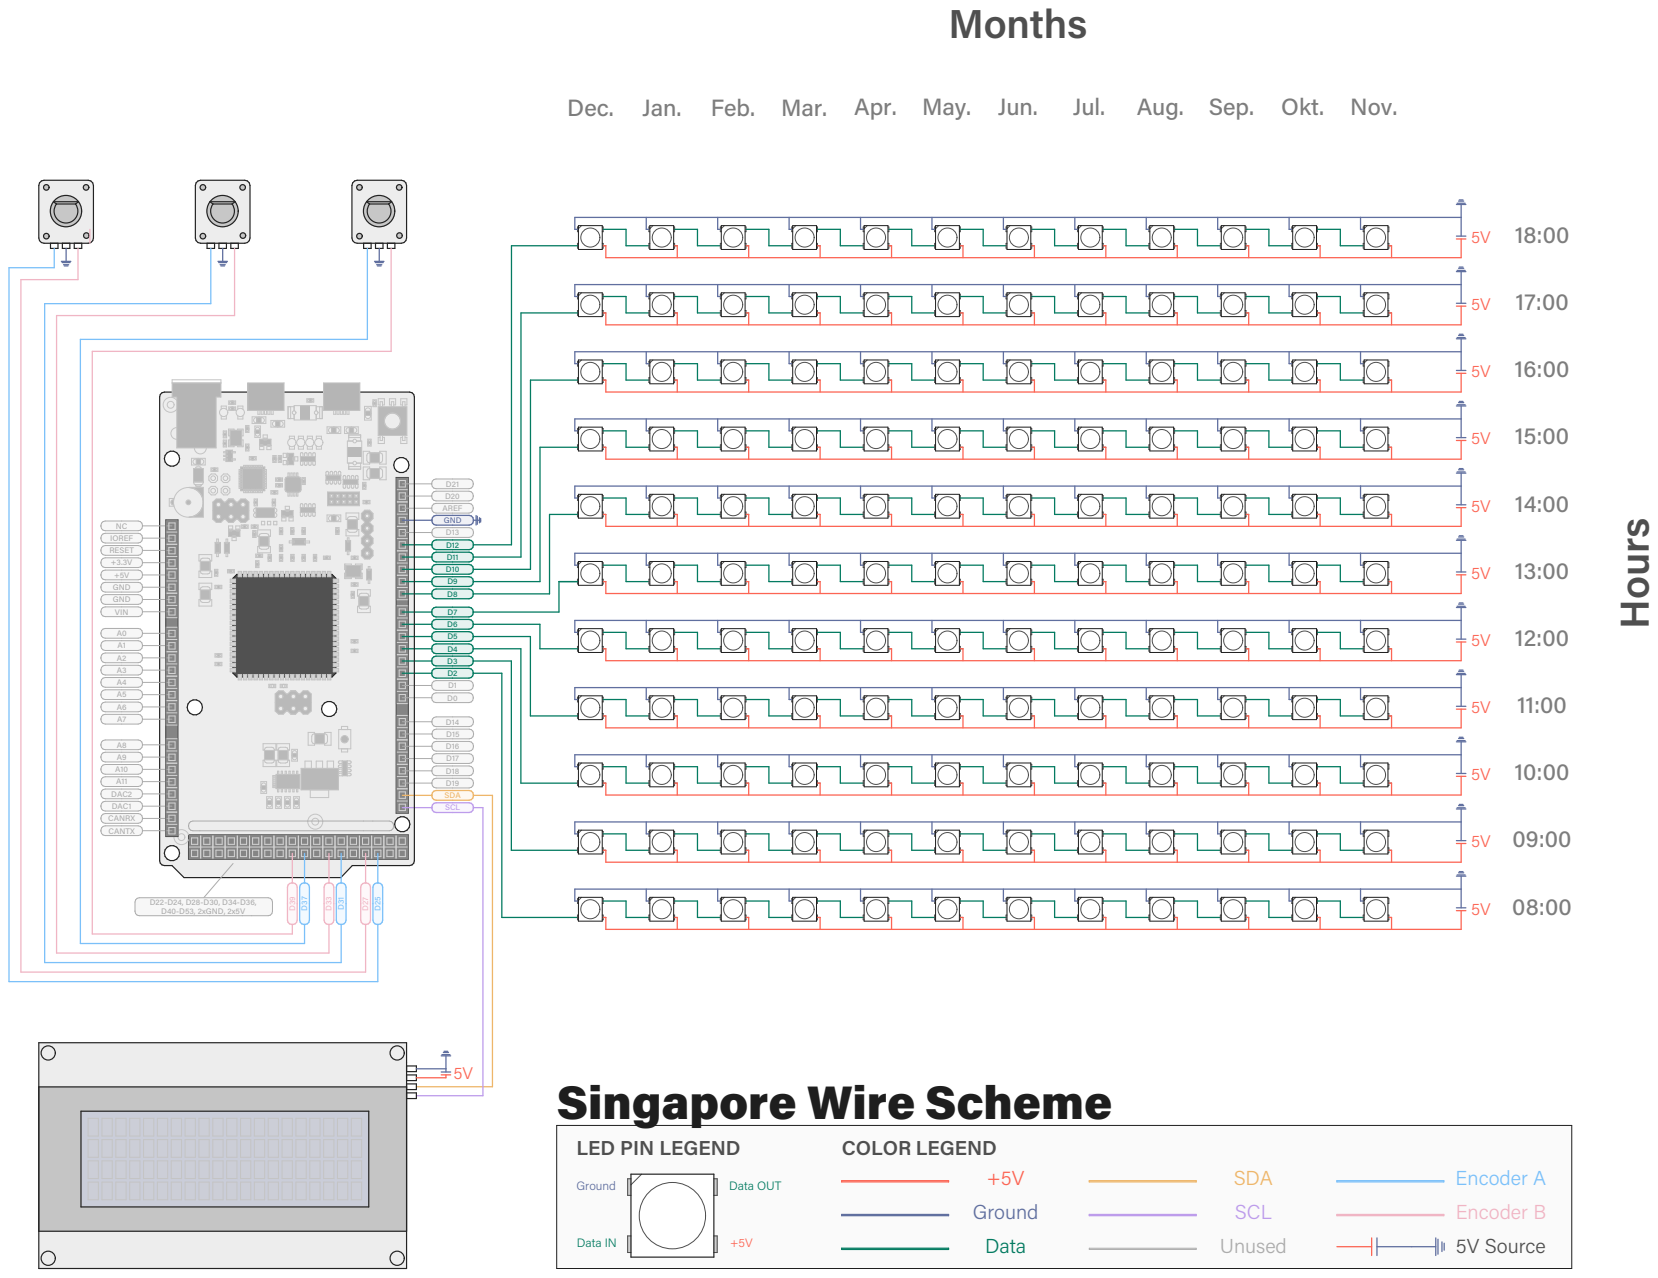
[picture p112: page 1]
