architecture-building-systems/FCL-Exhibition-2023-Arduino/09_Documentation/Images/schaltplan ZH.pdf

5V

5V

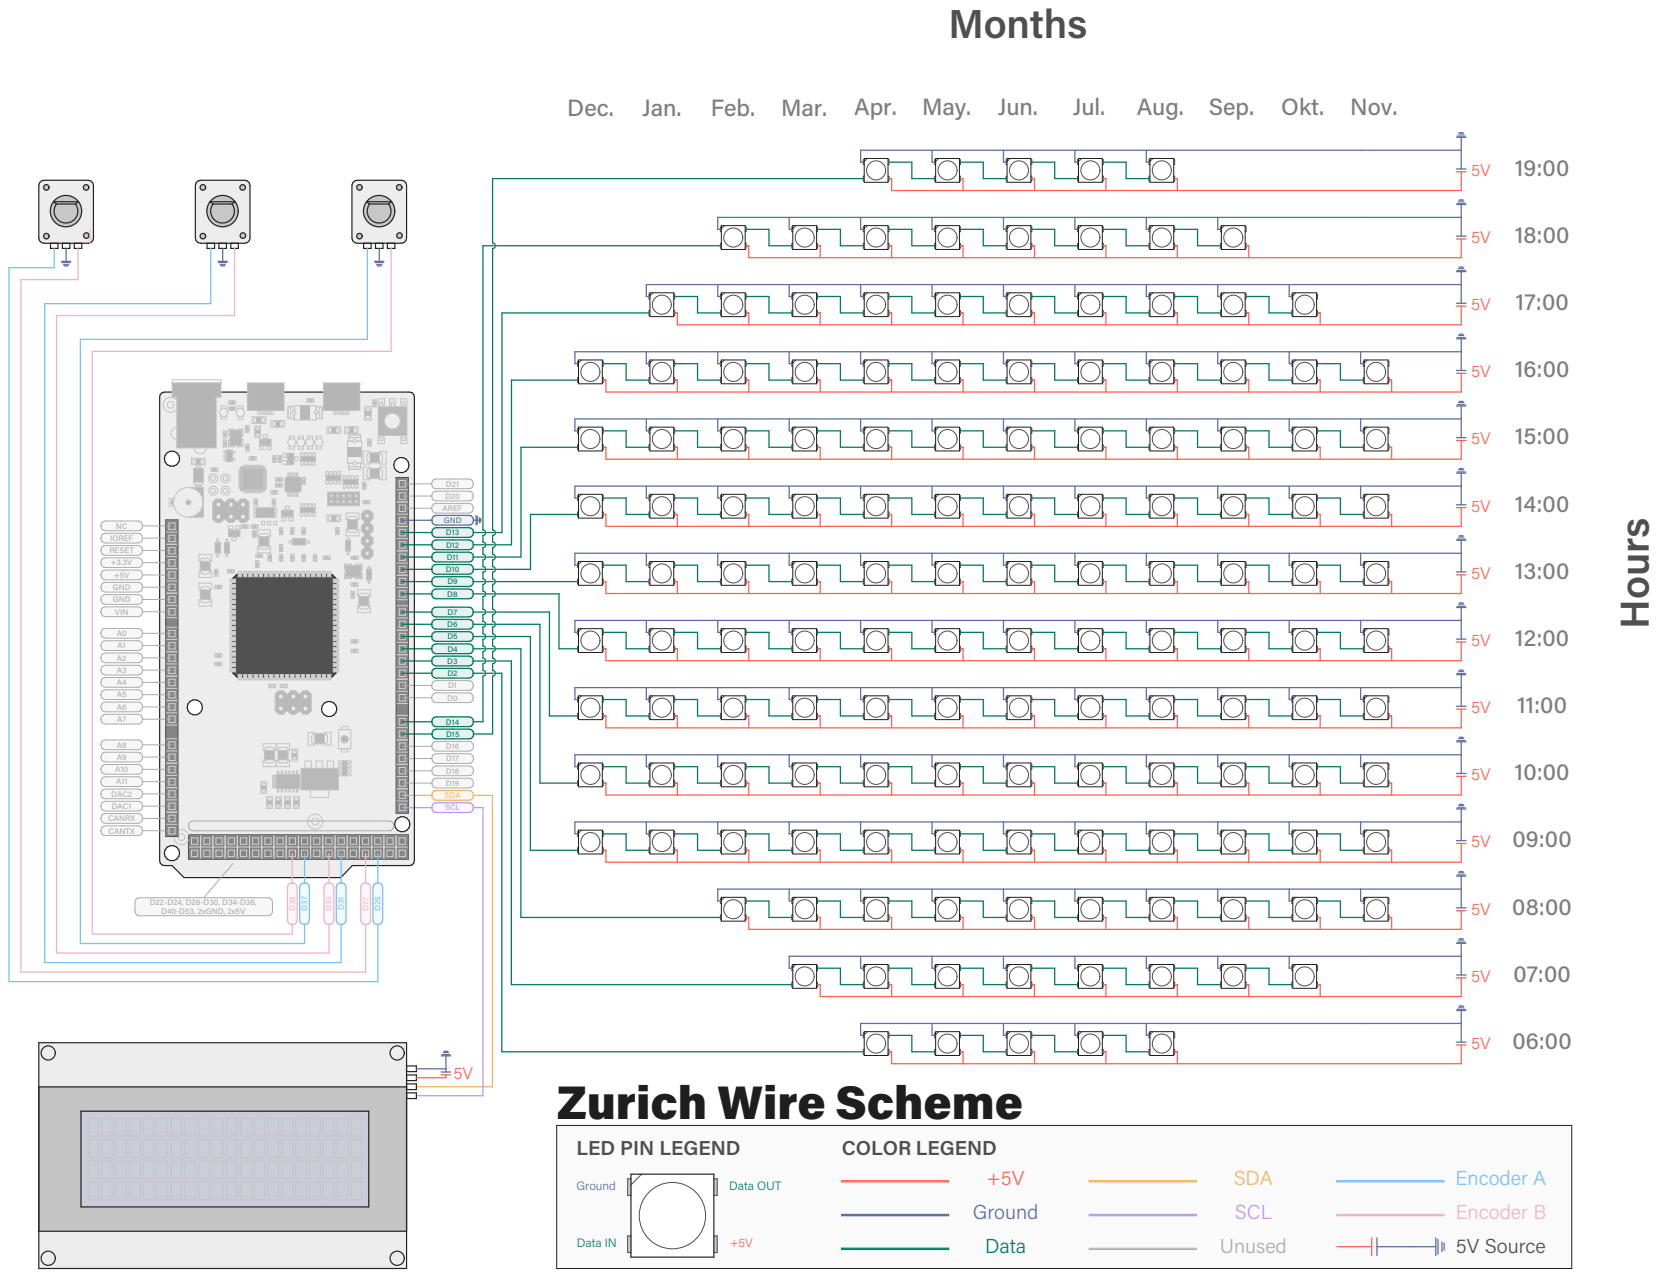
[picture p113: page 1]
