architecture-building-systems/FCL-Exhibition-2023-Arduino/09_Documentation/Images/cut sg.pdf

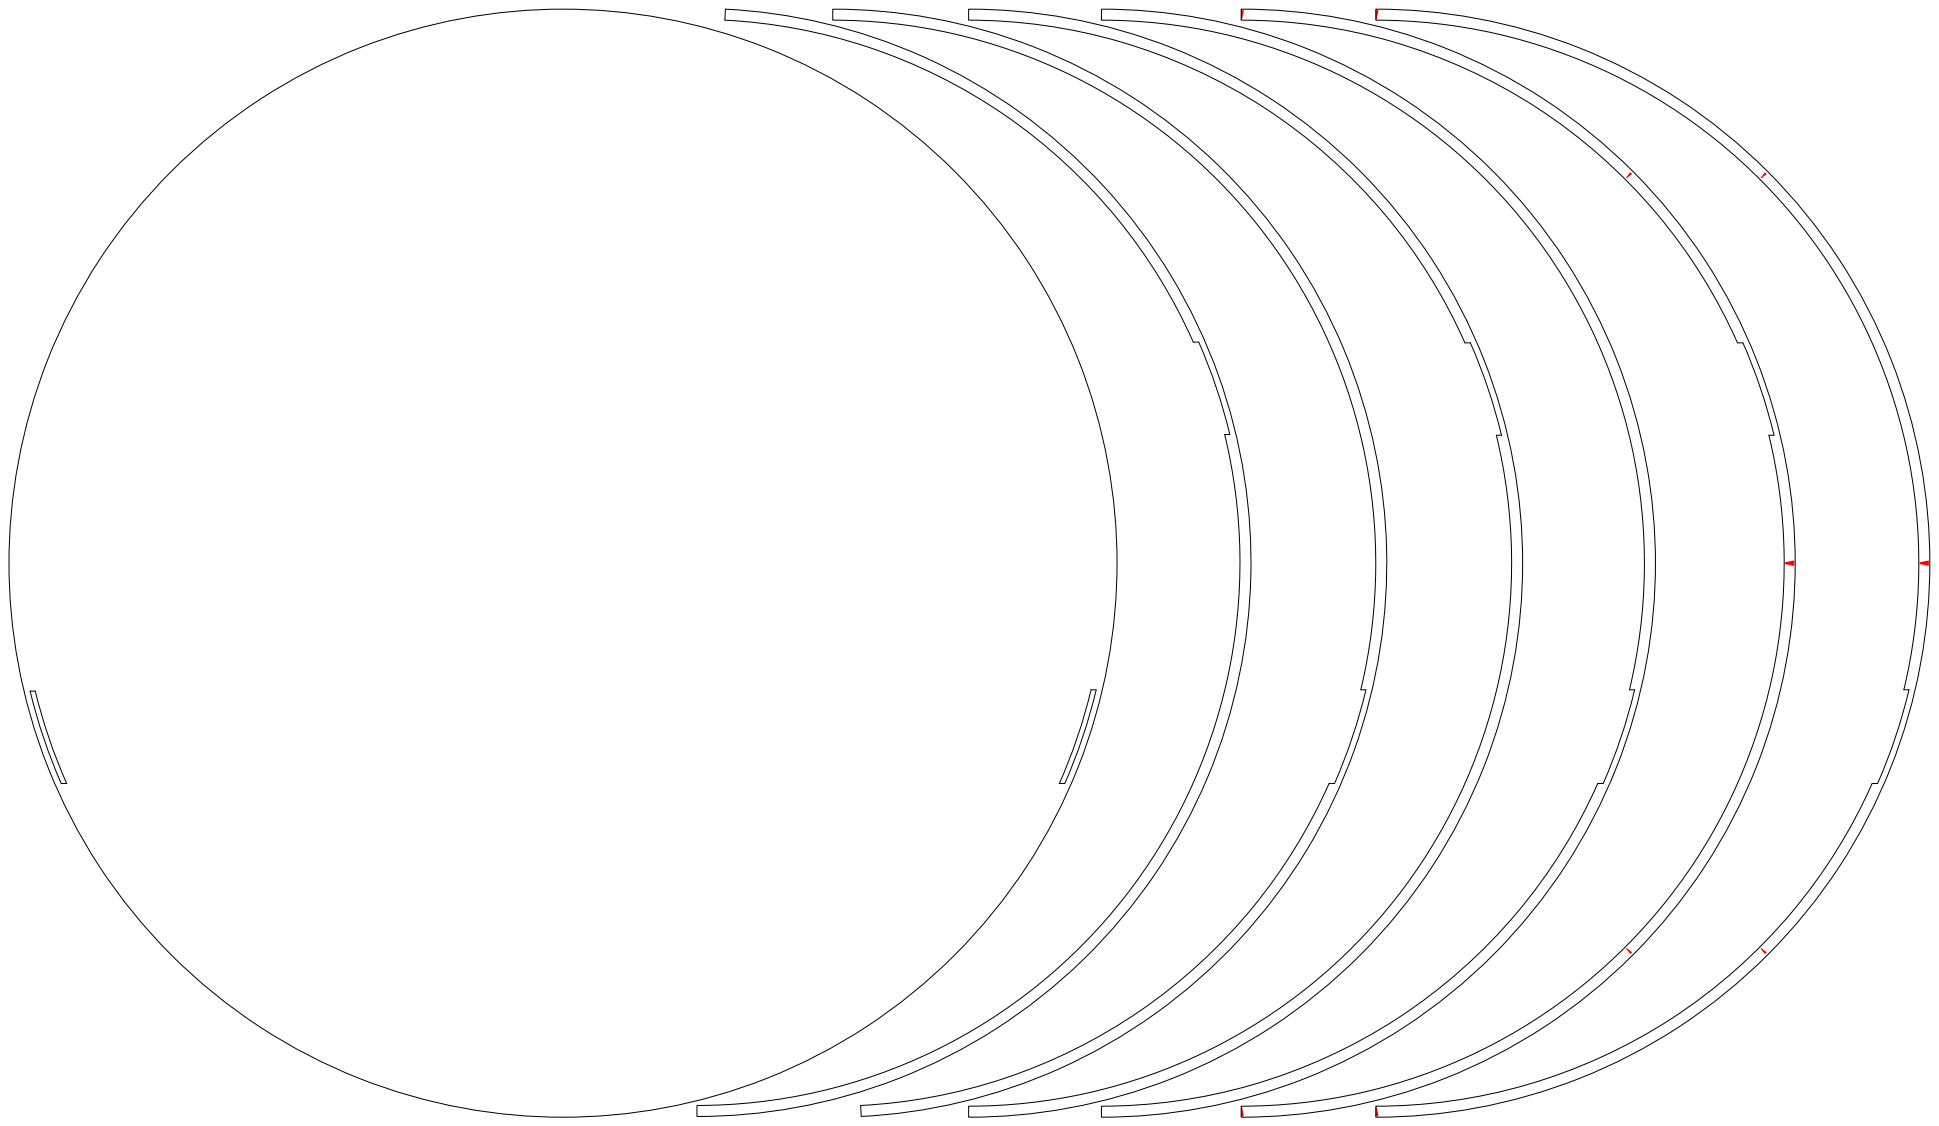
[picture p114: page 1]
