architecture-building-systems/FCL-Exhibition-2023-Arduino/09_Documentation/Images/cut zh.pdf

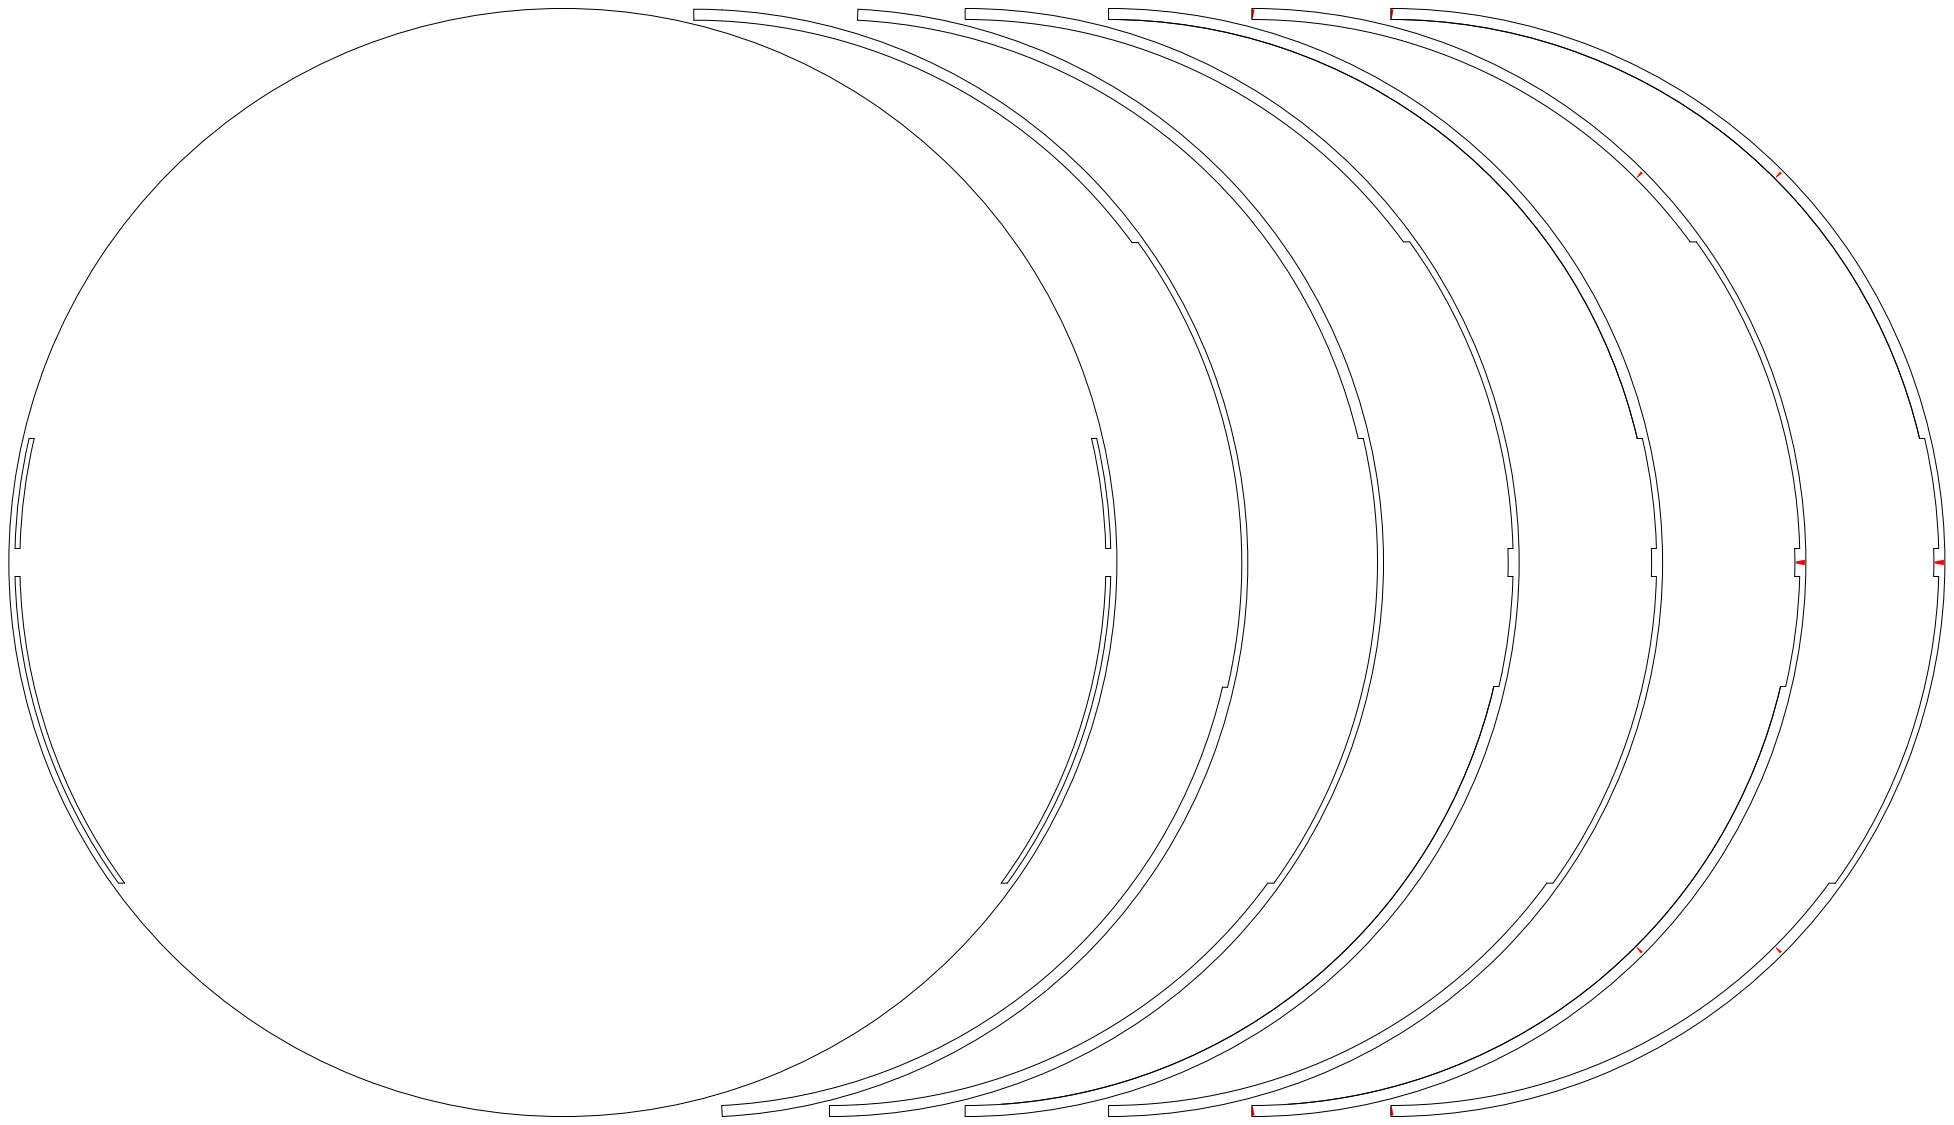
[picture p115: page 1]
