architecture-building-systems/FCL-Exhibition-2023-Arduino/05_Control Box/02_Cut Schemes/Control_Box_Cut_Scheme_Singapore.pdf

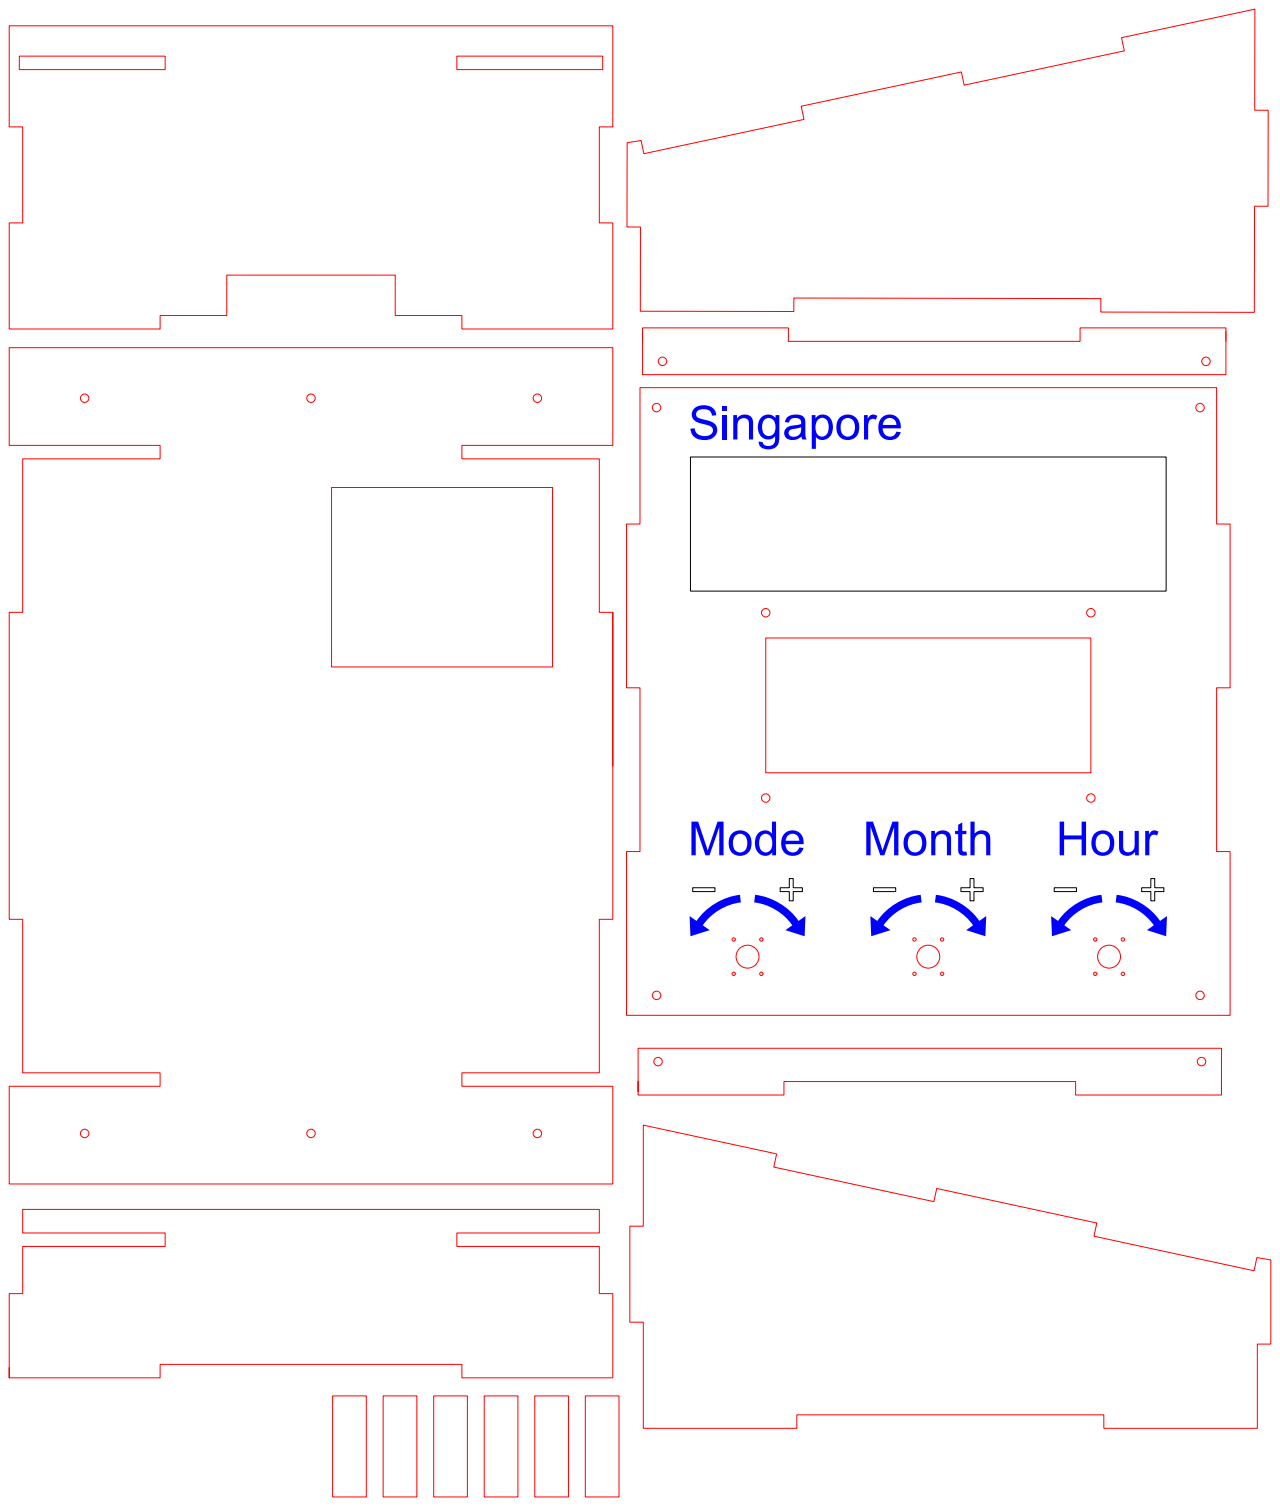
[picture p116: page 1]
