architecture-building-systems/FCL-Exhibition-2023-Arduino/05_Control Box/02_Cut Schemes/Control_Box_Cut_Scheme_Zurich.pdf

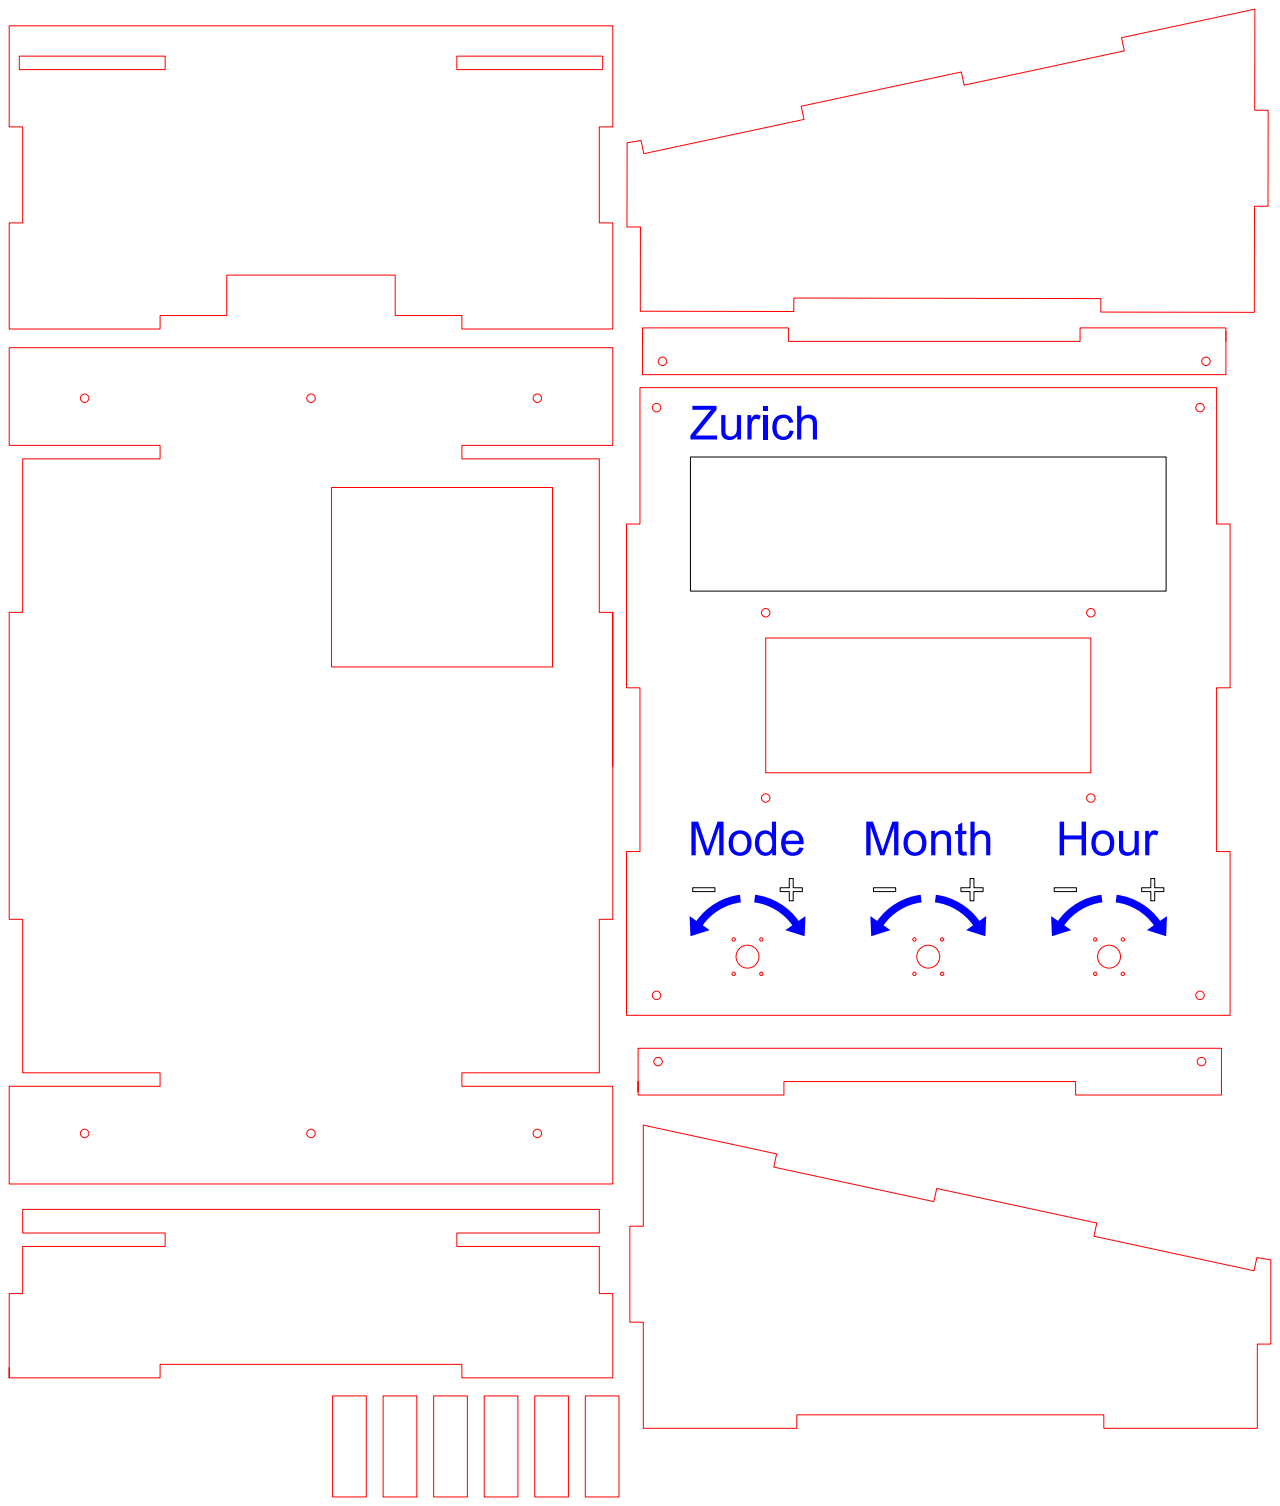
[picture p117: page 1]
