architecture-building-systems/FCL-Exhibition-2023-Arduino/09_Documentation/Images/e2.jpg

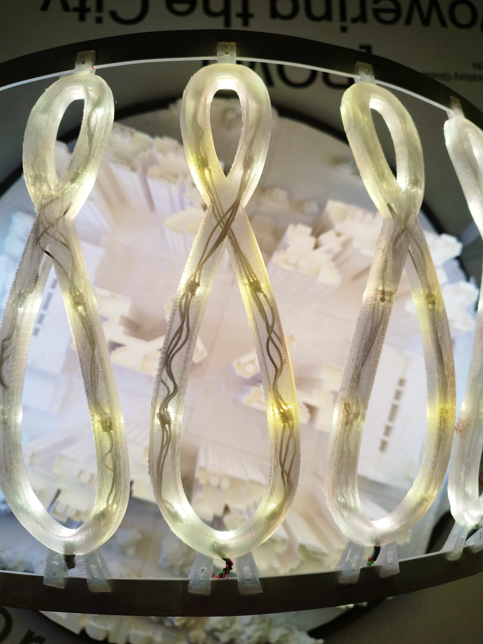
[picture p59: 09_Documentation/Images/e2.jpg]
09_Documentation/Images/e2.jpg
